lab11/persimmon/README.md

# persimmon
platform to test connectivity of cellular networks around the world
