lab11/persimmon/hardware/sim_card_tester/schematic_pcb.png

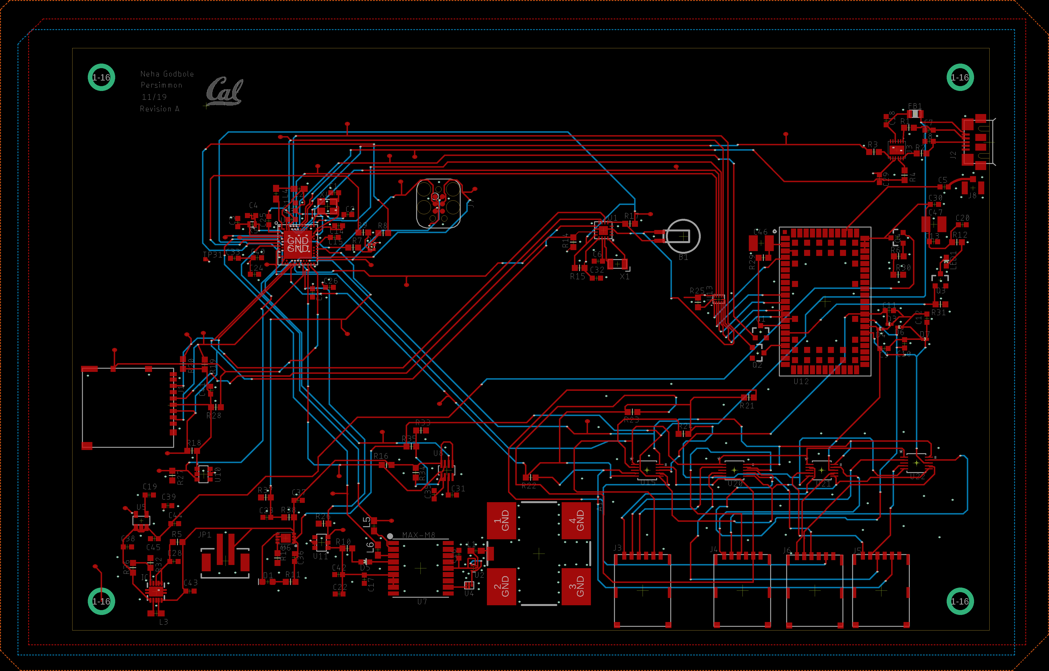
hardware/sim_card_tester/schematic_pcb.png
