lab11/persimmon/hardware/sim_card_tester/schematic.pdf

https://www.u-blox.com/sites/default/files/MAX-8-M8-FW3_HardwareIntegrationManual_%28UBX-15030059%29.pdf

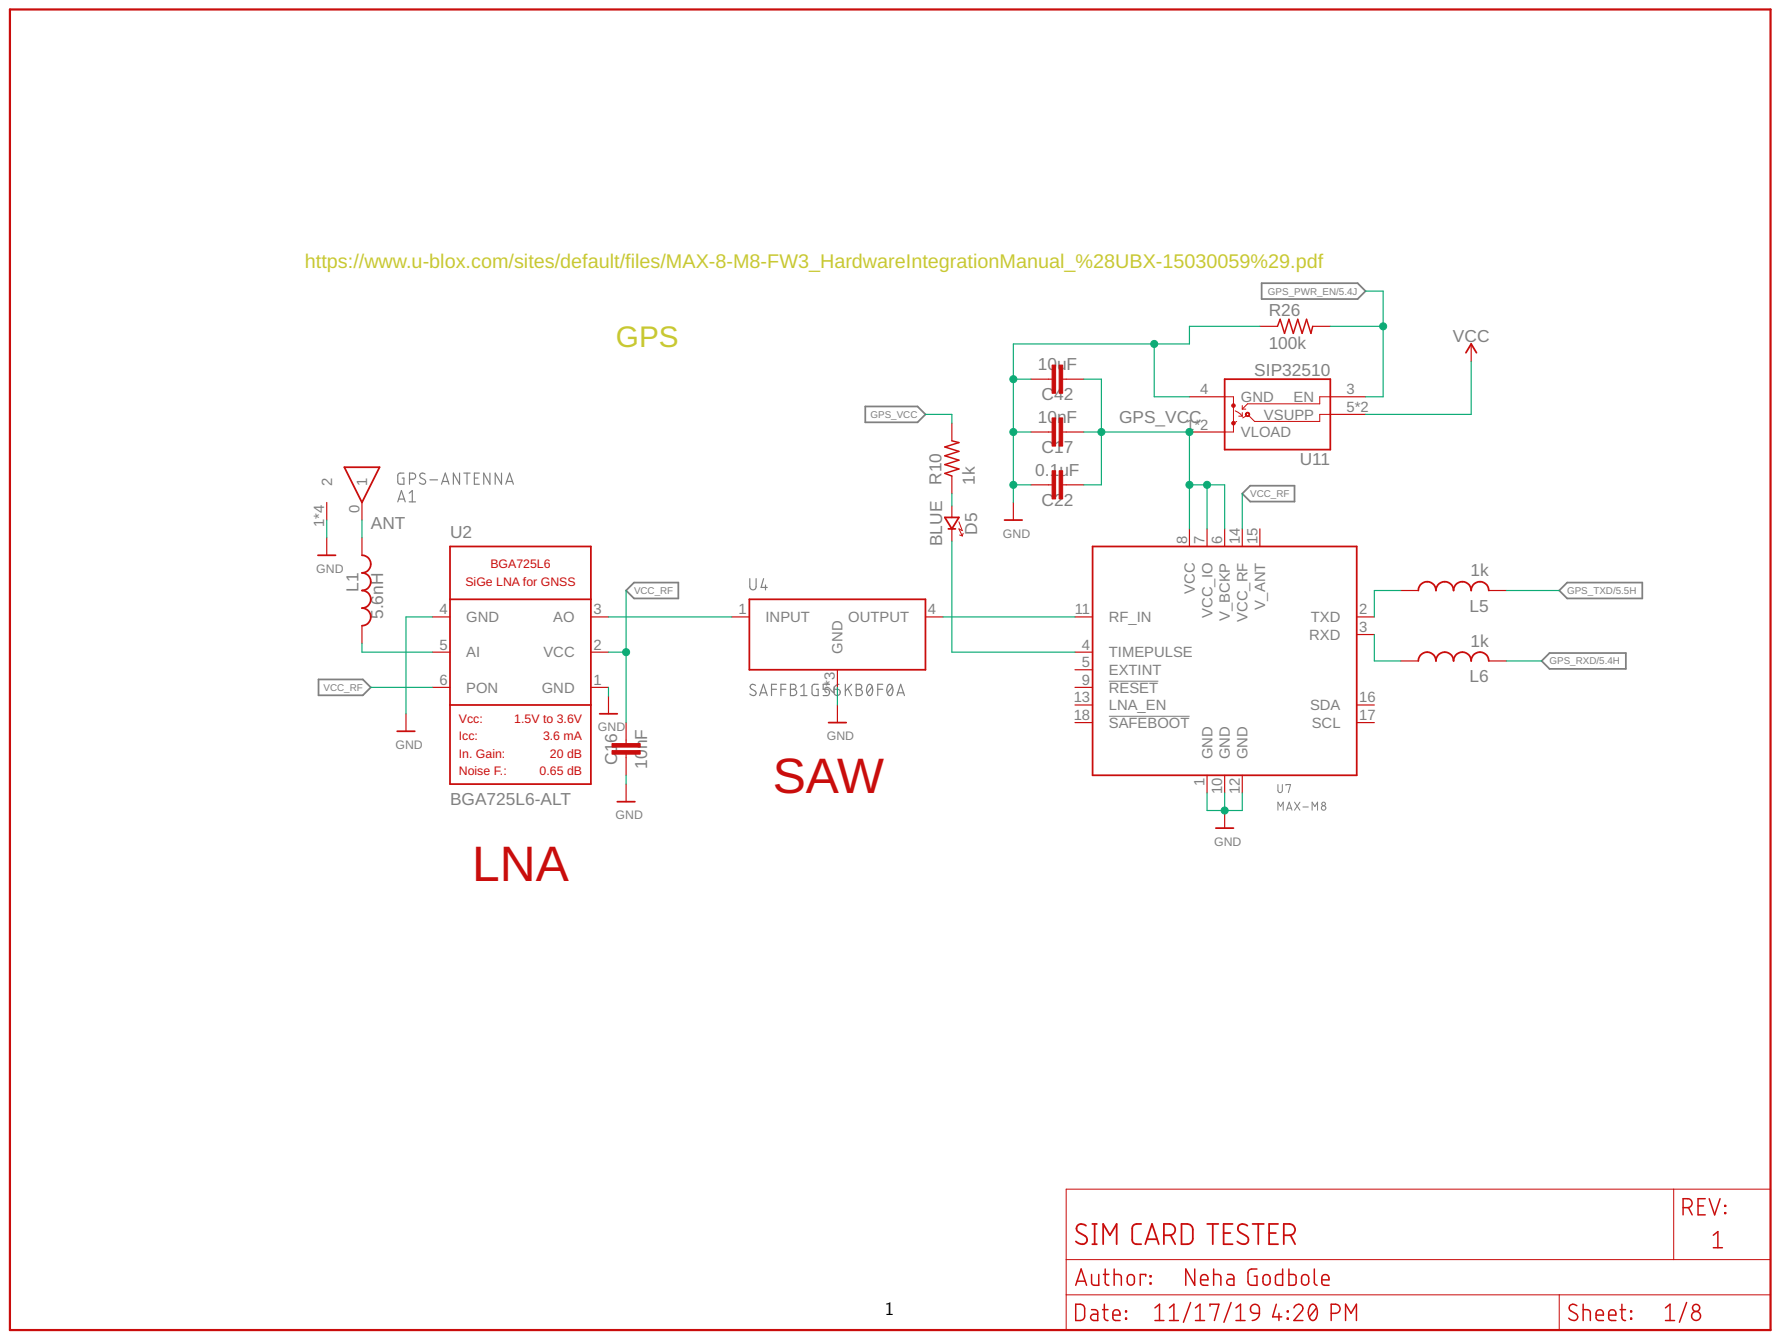
[picture p2: page 1]

Battery plugs in here | PFET to gate the system. Add jumper incase reverse diode voltage
| drop doesn't work as expected with the charging circuit

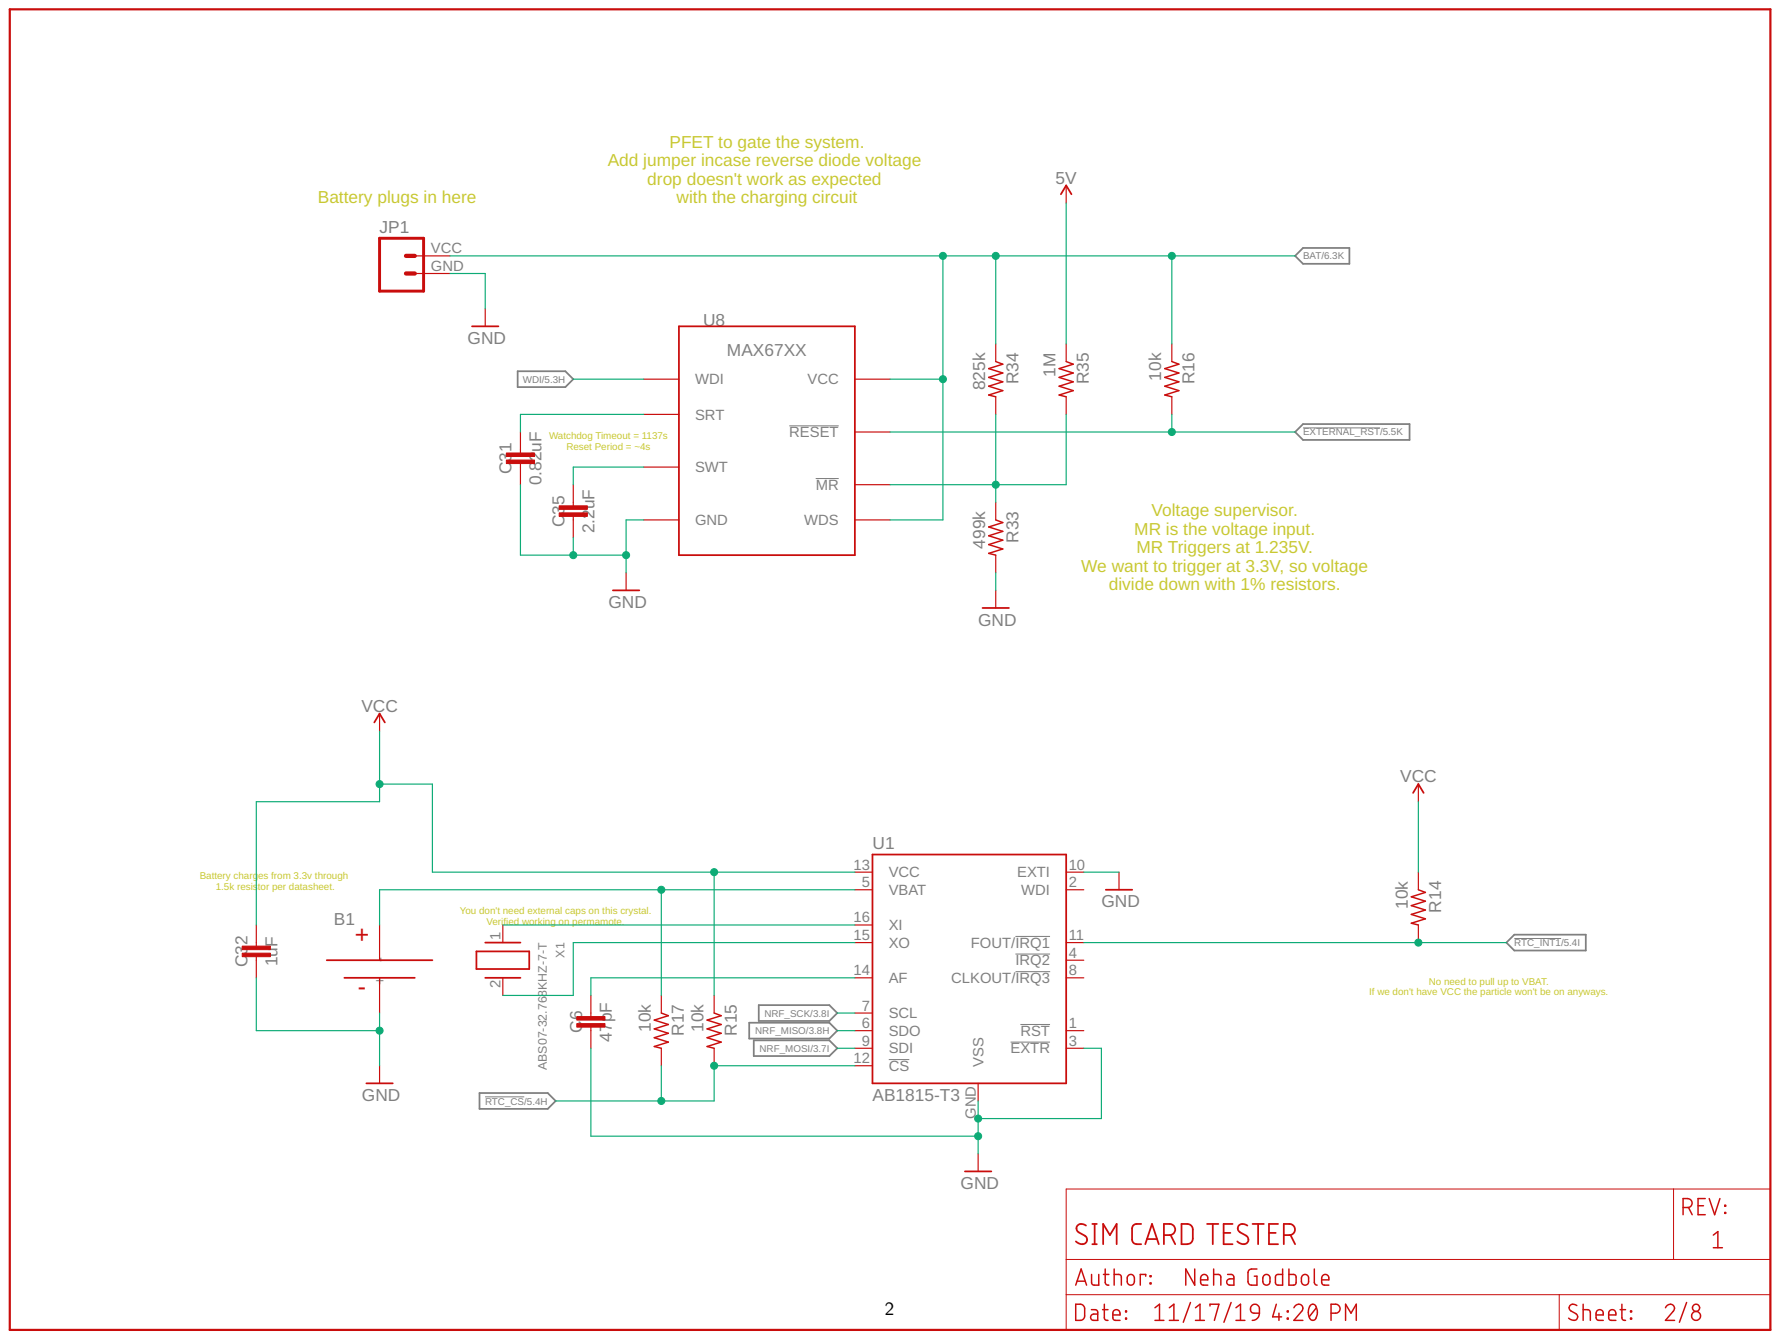
[picture p3: page 2]

Watchdog Timeout = 1137s Reset Period = ~4s

Voltage supervisor. MR is the voltage input. MR Triggers at 1.235V. We want to trigger at 3.3V, so voltage

divide down with 1% resistors.

You don't need external caps on this crystal. Verified working on permamote. Battery charges from 3.3v through
1.5k resistor per datasheet.

If we don't have VCC the particle won't be on anyways.

No need to pull up to VBAT.

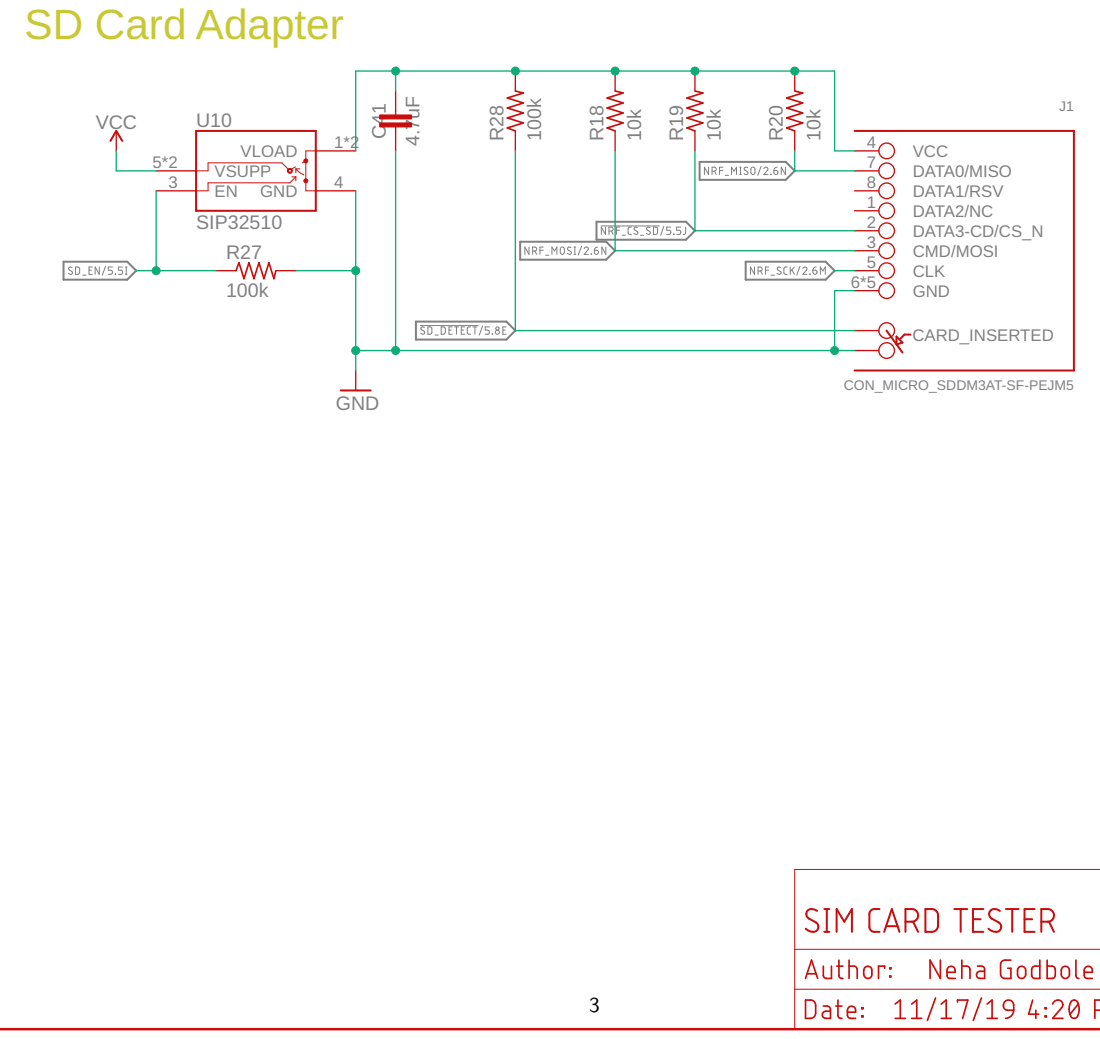
[picture p4: page 3]
3 SD Card Adapter; CARD_INSERTED ⁴.7uF GND; CON_MICRO_SDDM3AT-SF-PEJM5 SIP32510 100k; 10kVCC; C⁴¹; DATA0/MISO 7; DATA1/RSV 8; DATA2/NC 1; DATA3-CD/CS_N 2; CMD/MOSI 3; CLK 5; VCC 4; GND 6*5; J1 VSUPP 5*2; VLOAD; 1*2 GND; R²⁸; R¹⁸; R¹⁹; R²⁰

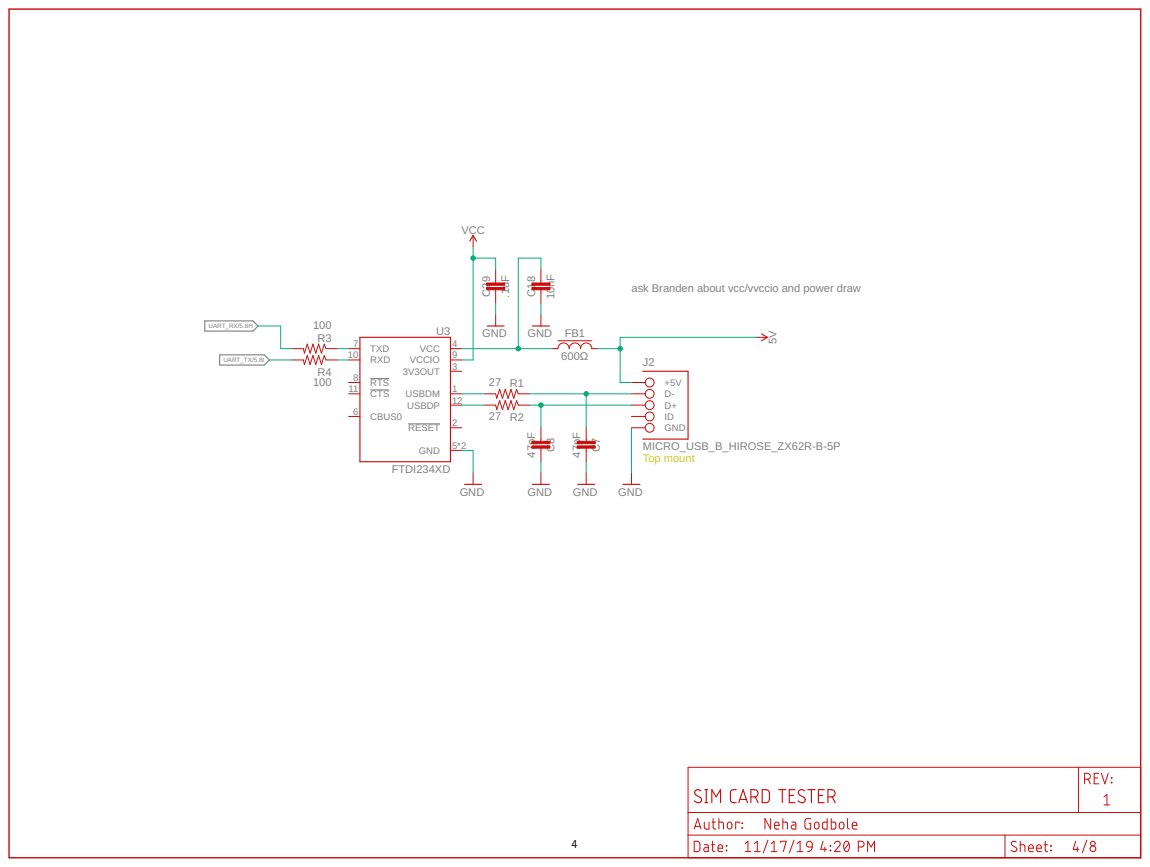
[picture p5: page 4]

ask Branden about vcc/vvccio and power draw

# GND

15nH | 10uH

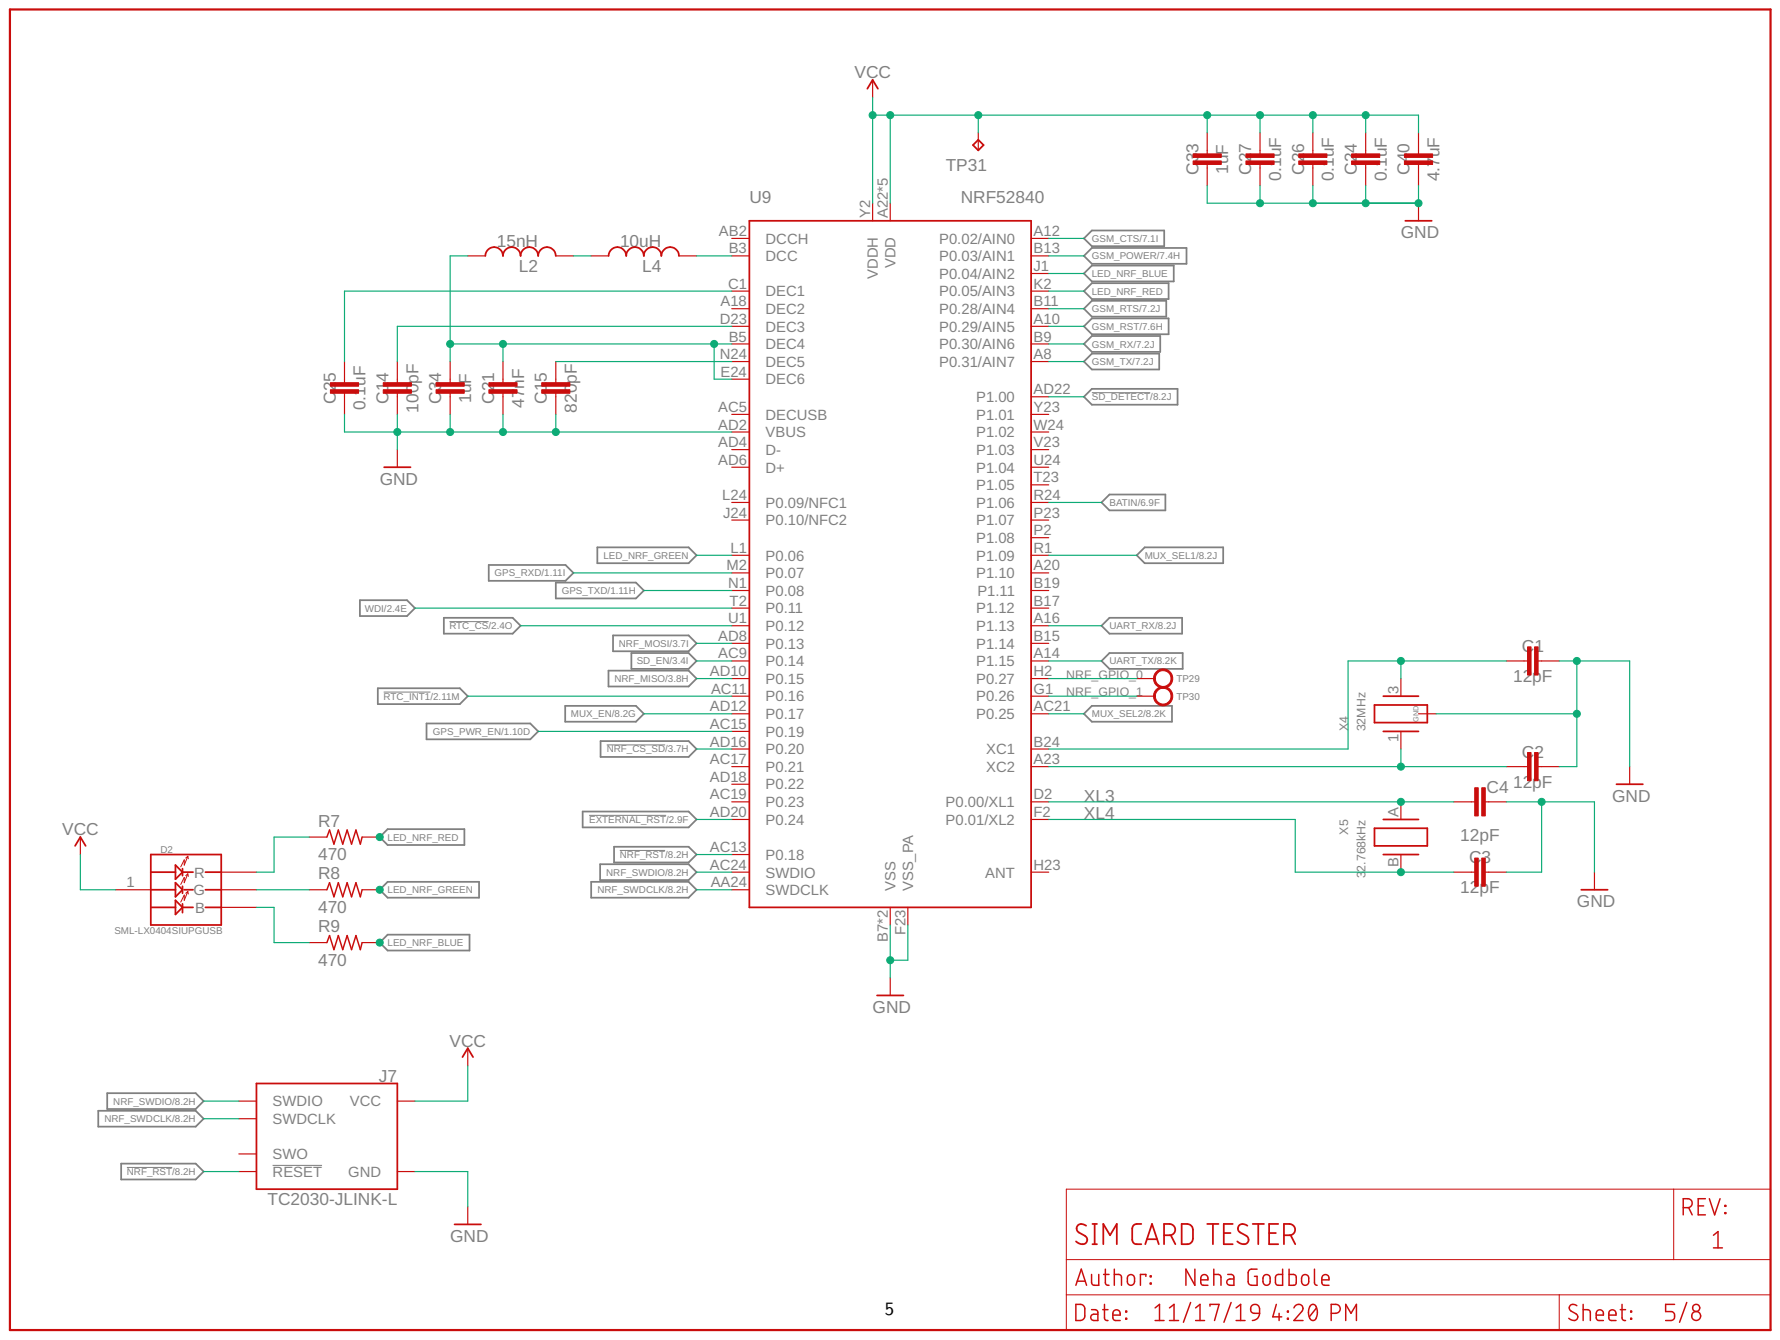
[picture p6: page 5]

# Power Supply and Charging

STAT | VSS GND U6

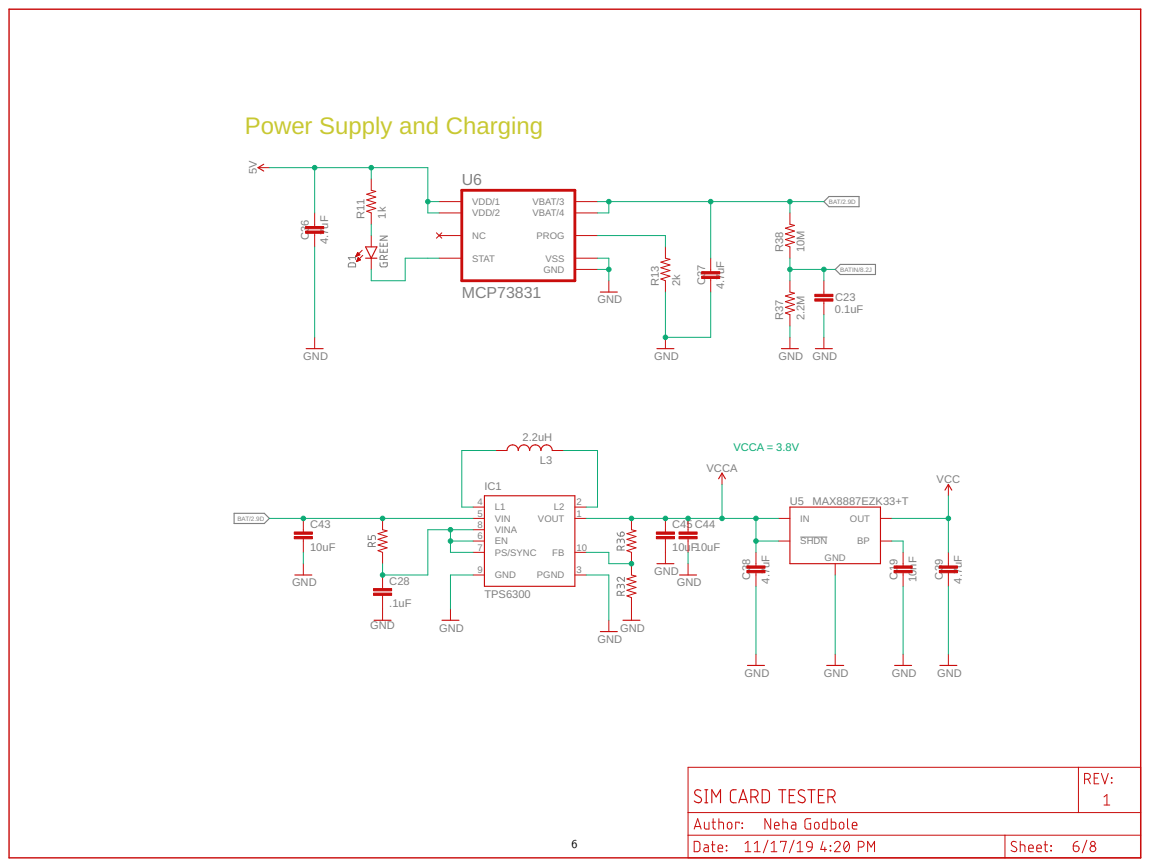
[picture p7: page 6]

# Level Translator, GSM_INT = 1.8V

# VCCA

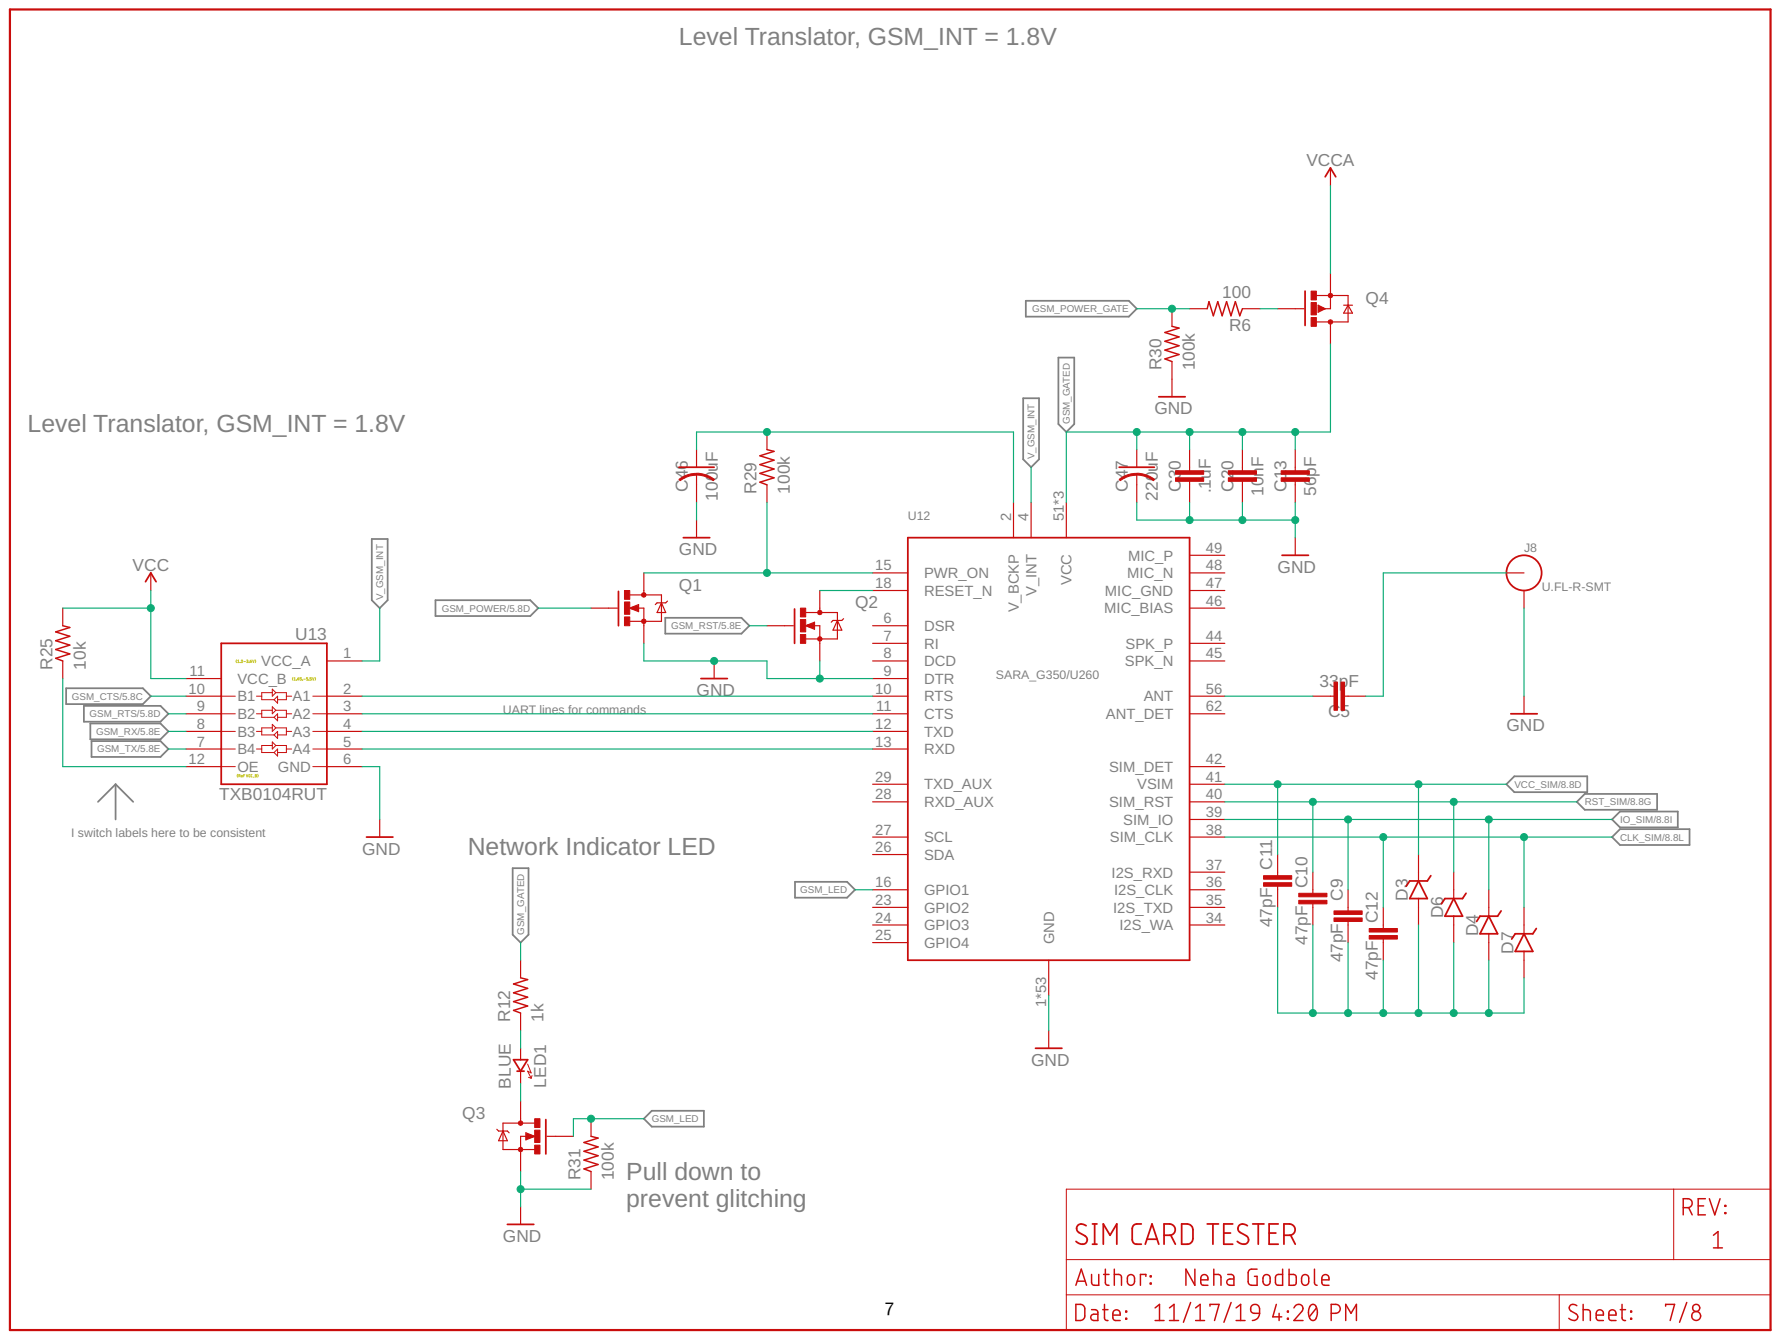
[picture p8: page 7]

UART lines for commands Network Indicator LED

I switch labels here to be consistent

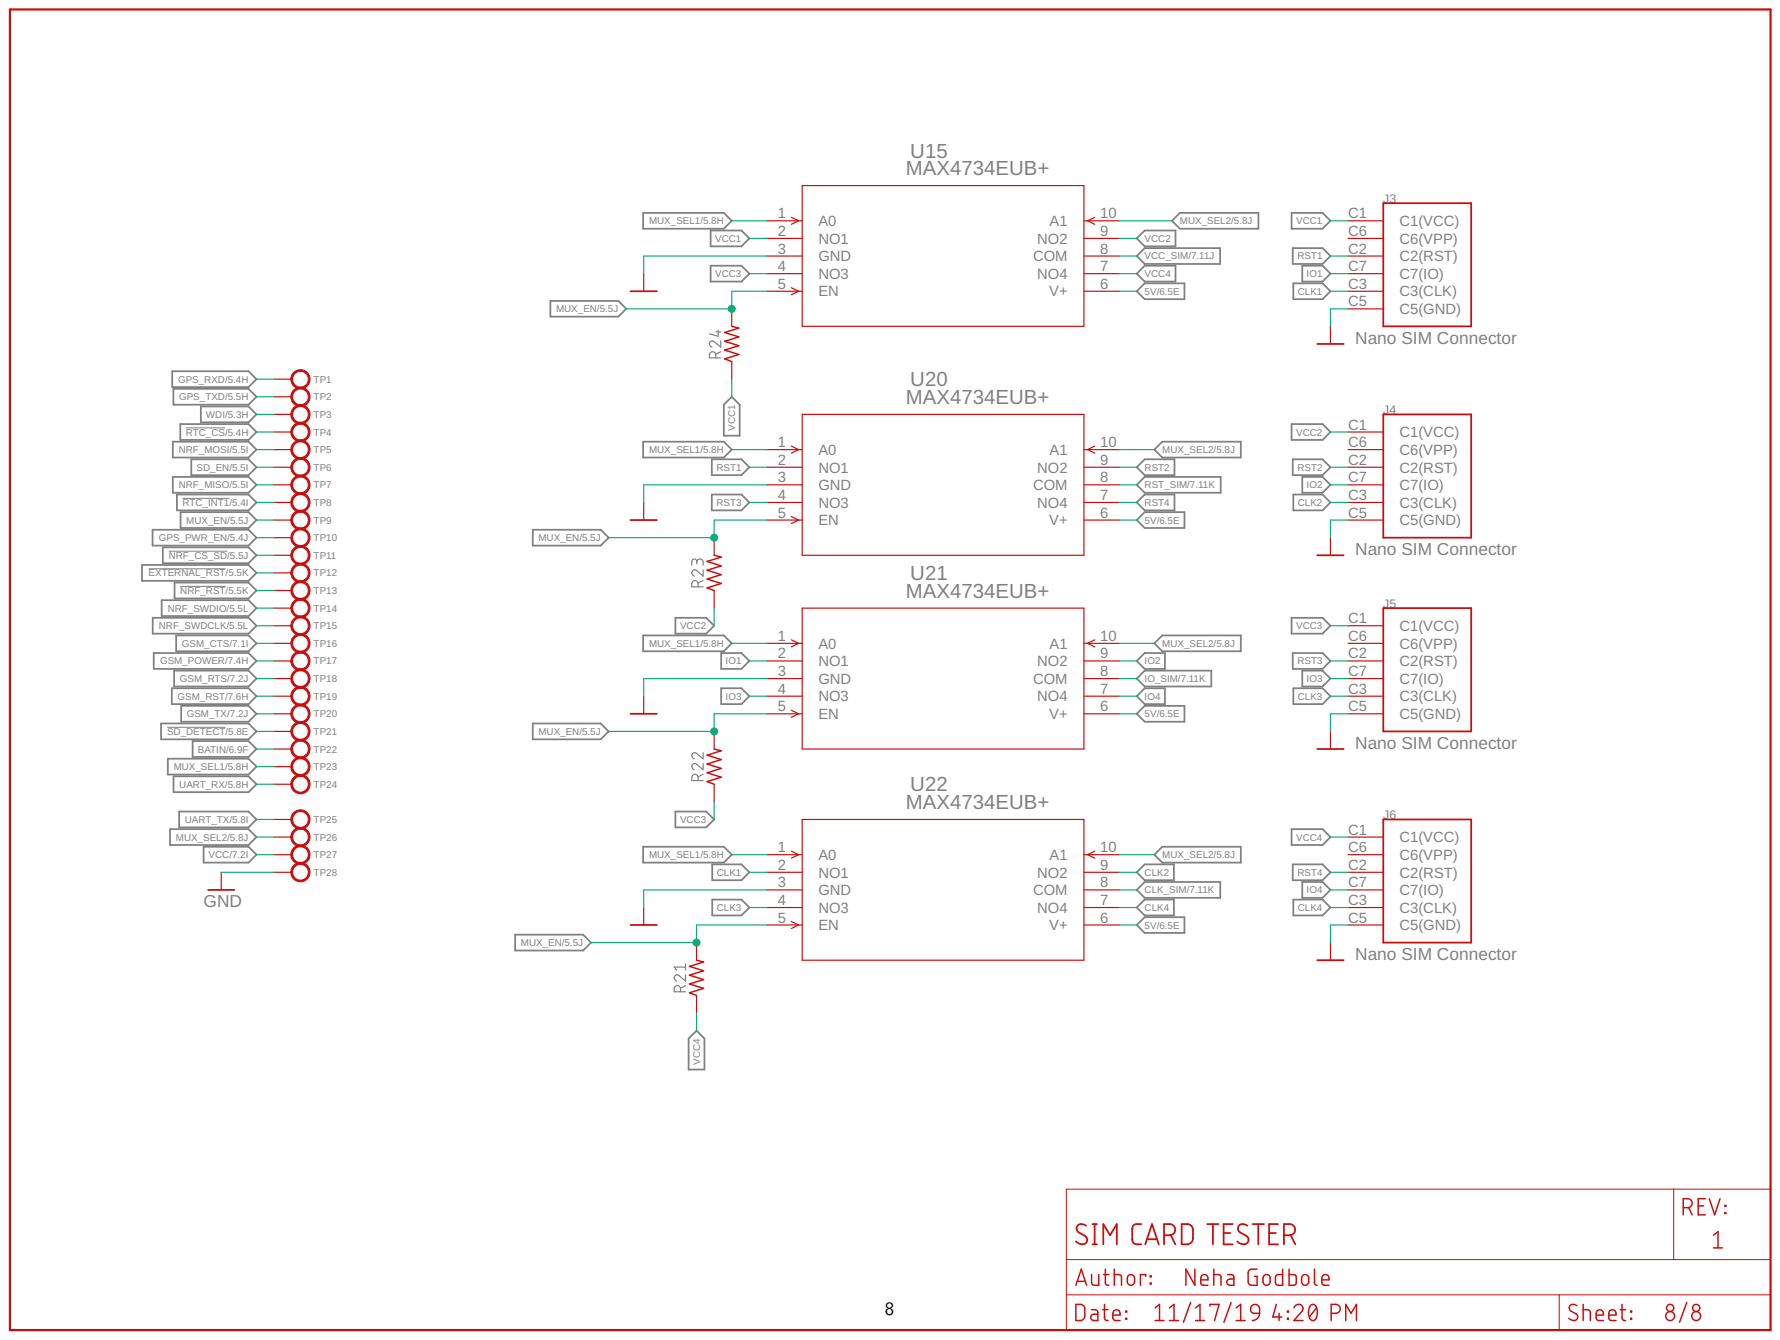
[picture p9: page 8]

Top and Bottom Layers 9 | * | * | * | * L5 L6

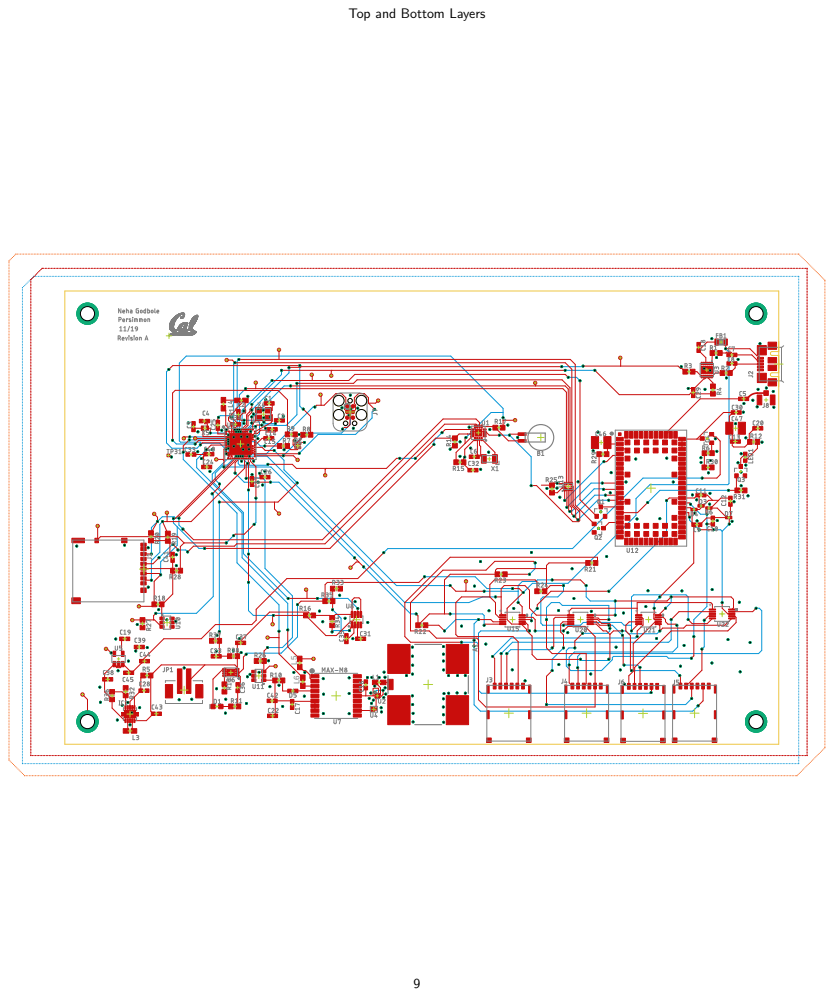
[picture p10: page 9]

# Top Layer

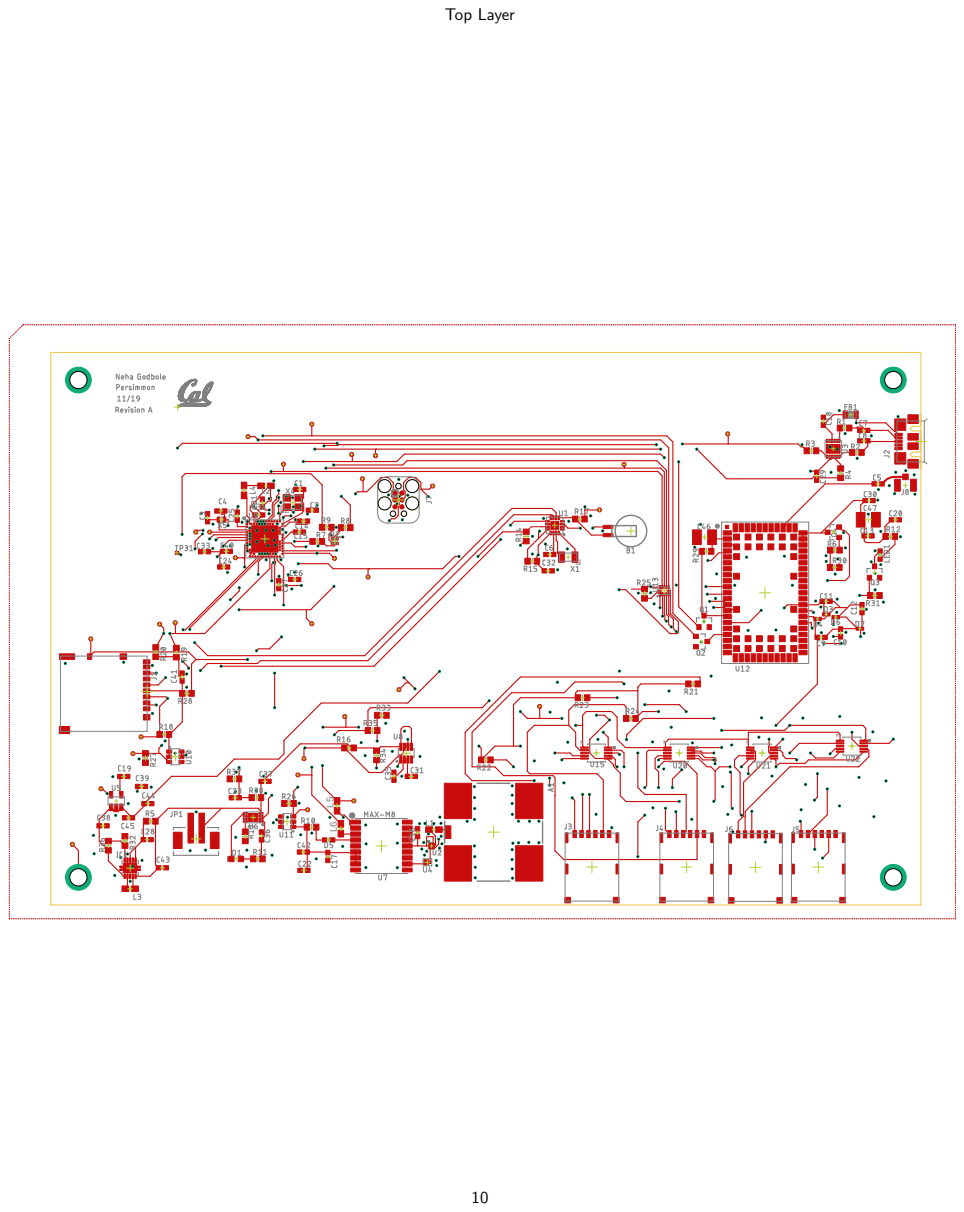
[picture p11: page 10]

# Bottom Layer

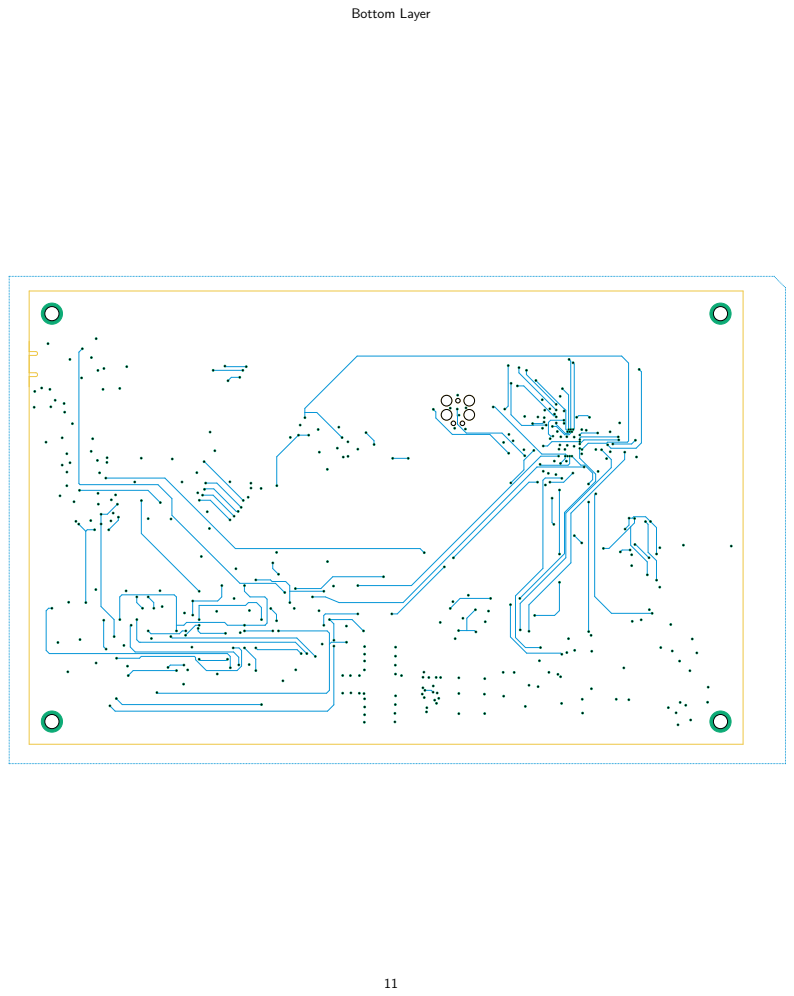
[picture p12: page 11]

# Top Copper Layer

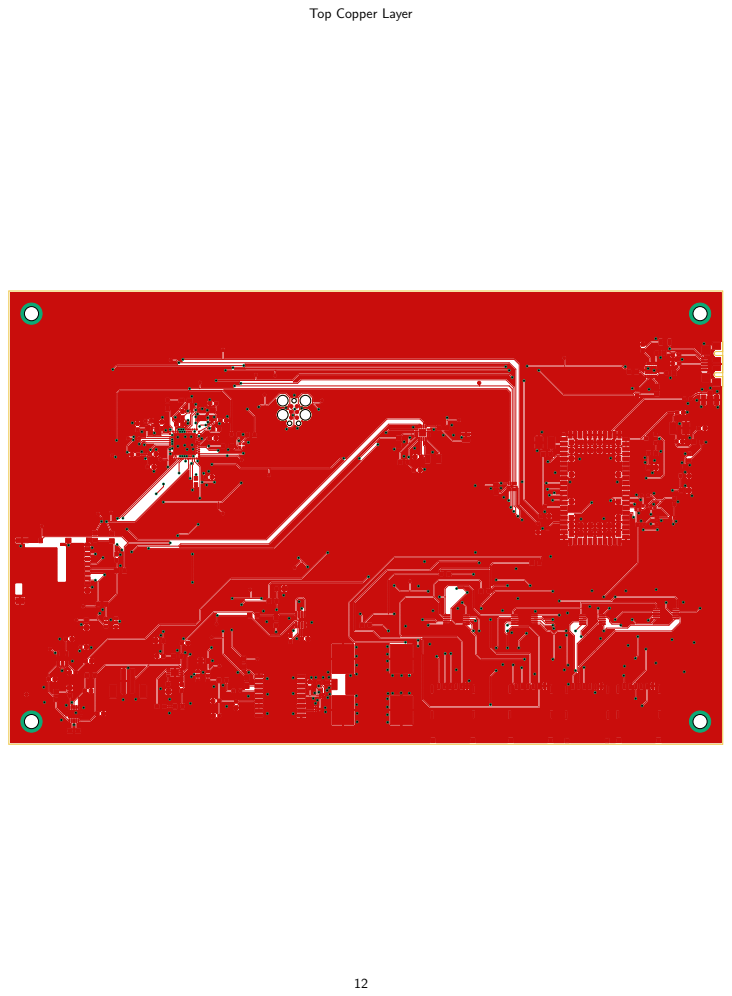
[picture p13: page 12]

# Layer 2 Copper

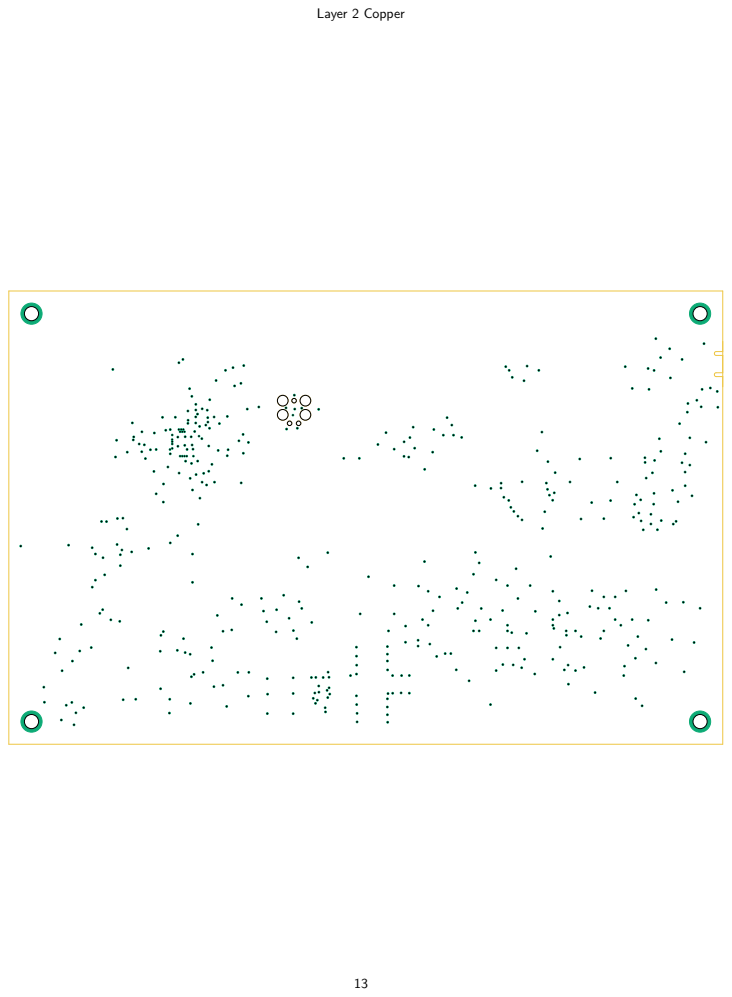
[picture p14: page 13]

# Layer 3 Copper

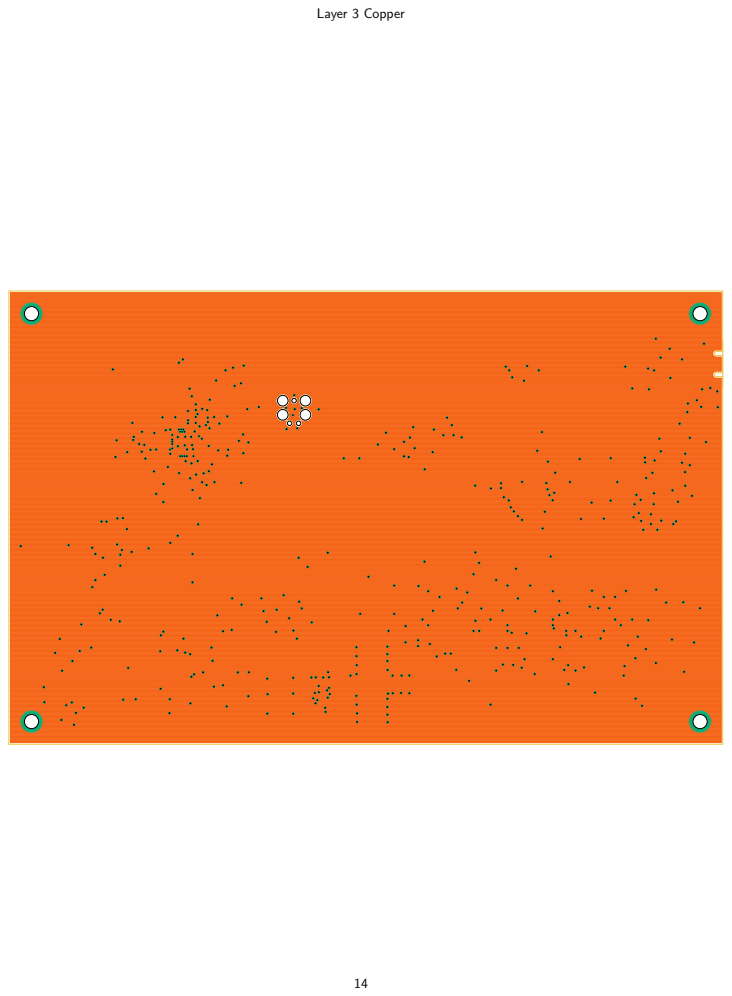
[picture p15: page 14]

# Bottom Copper Layer

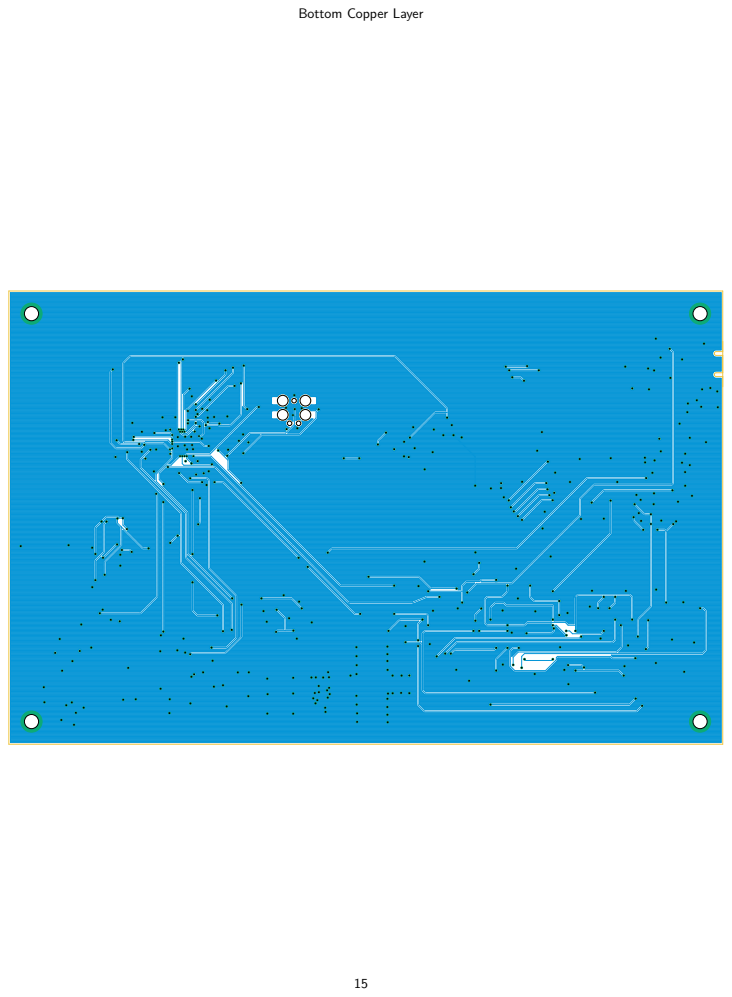
[picture p16: page 15]

# Top Paste Layer with Silkscreen

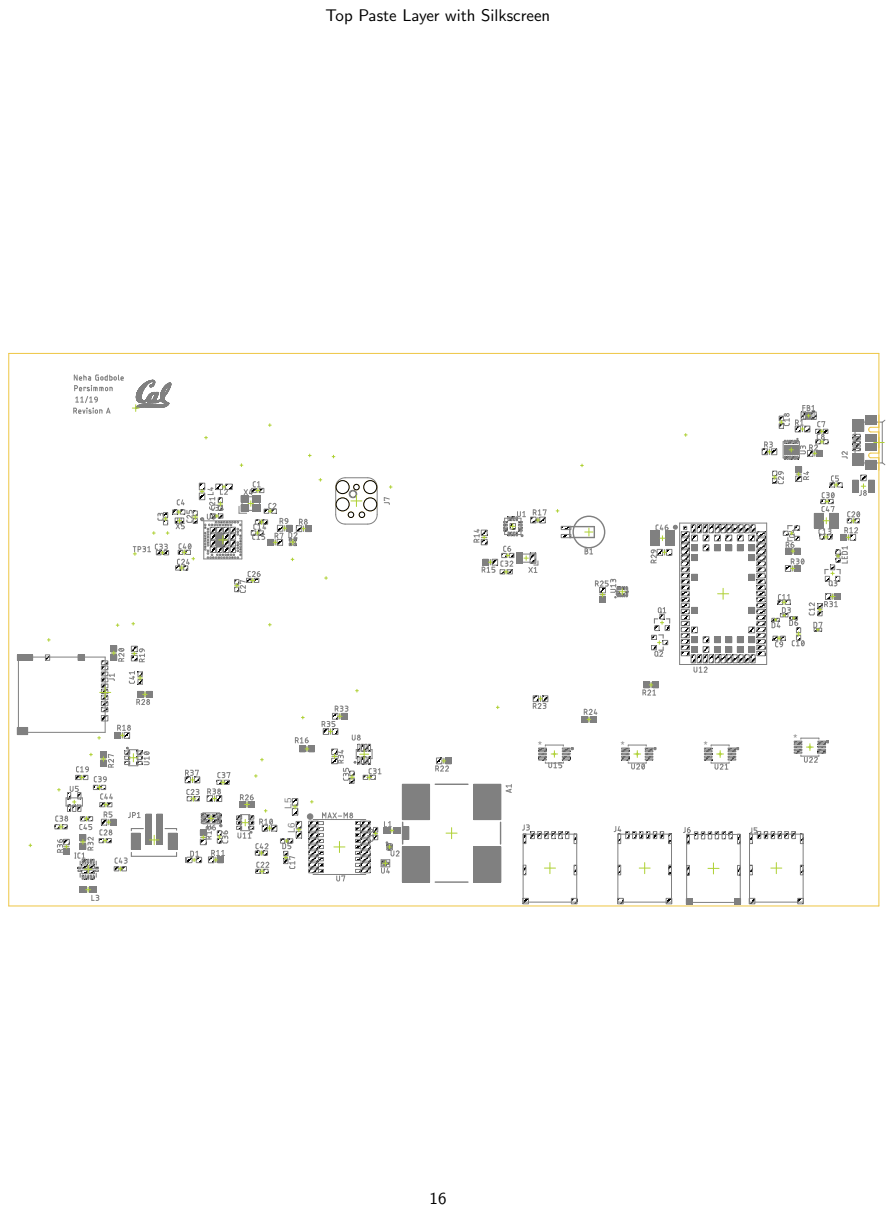
[picture p17: page 16]

# Bottom Paste Layer with Silkscreen

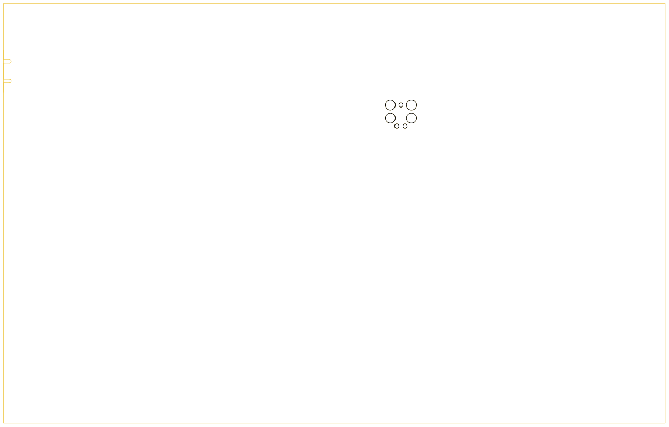
[picture p18: figure]

# Top and Bottom Layers 1:1 Scale

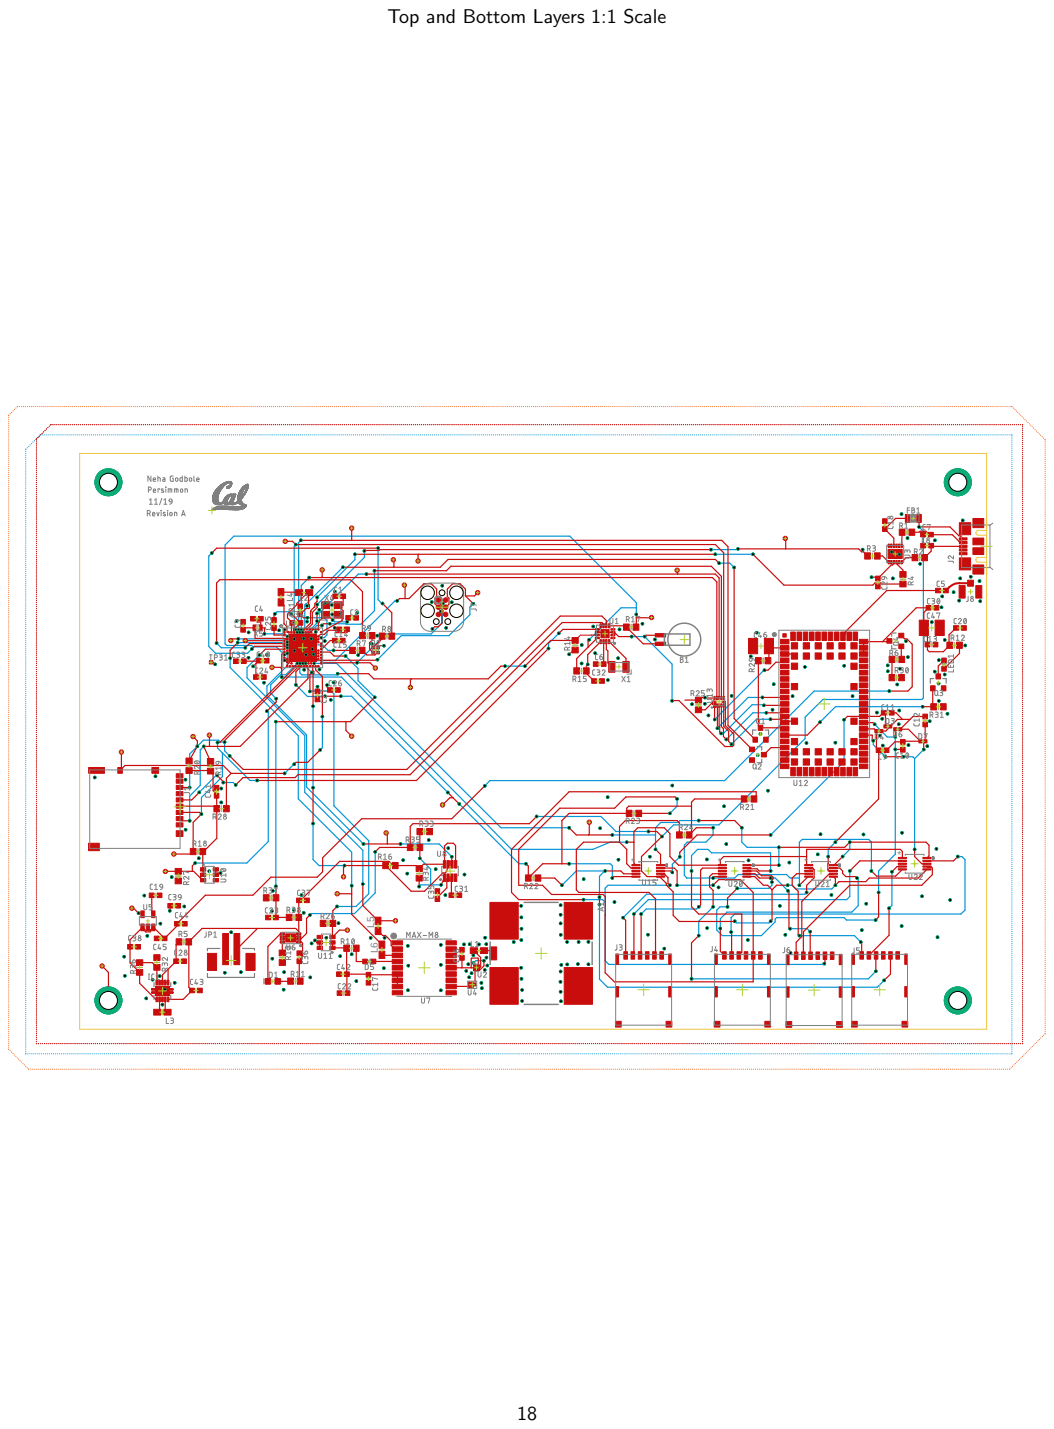
[picture p19: page 18]

# Top Layer 1:1 Scale

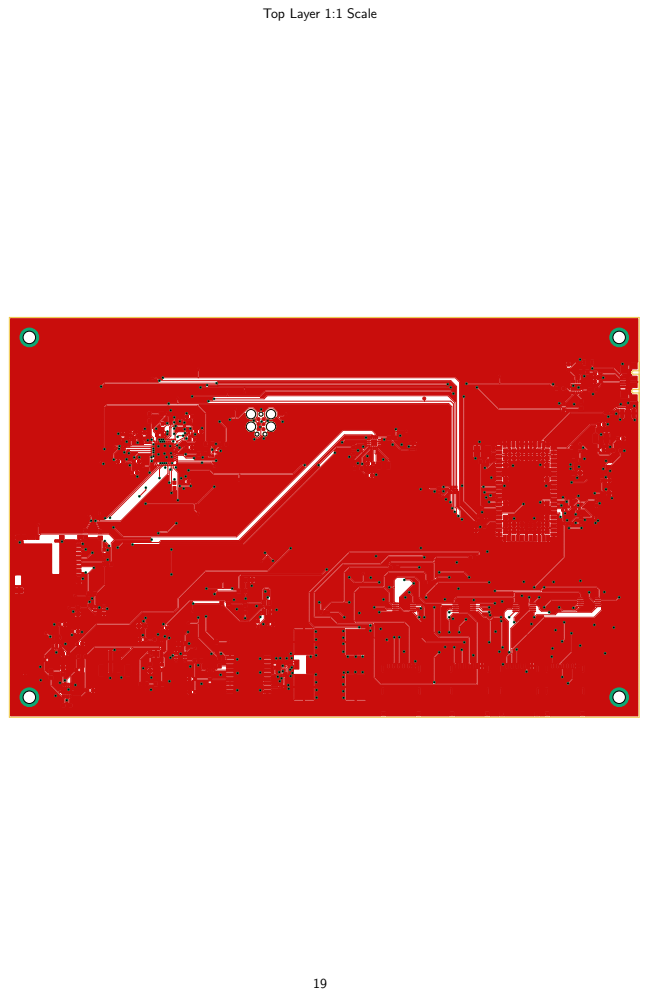
[picture p20: page 19]

# Layer 2 Copper 1:1 Scale

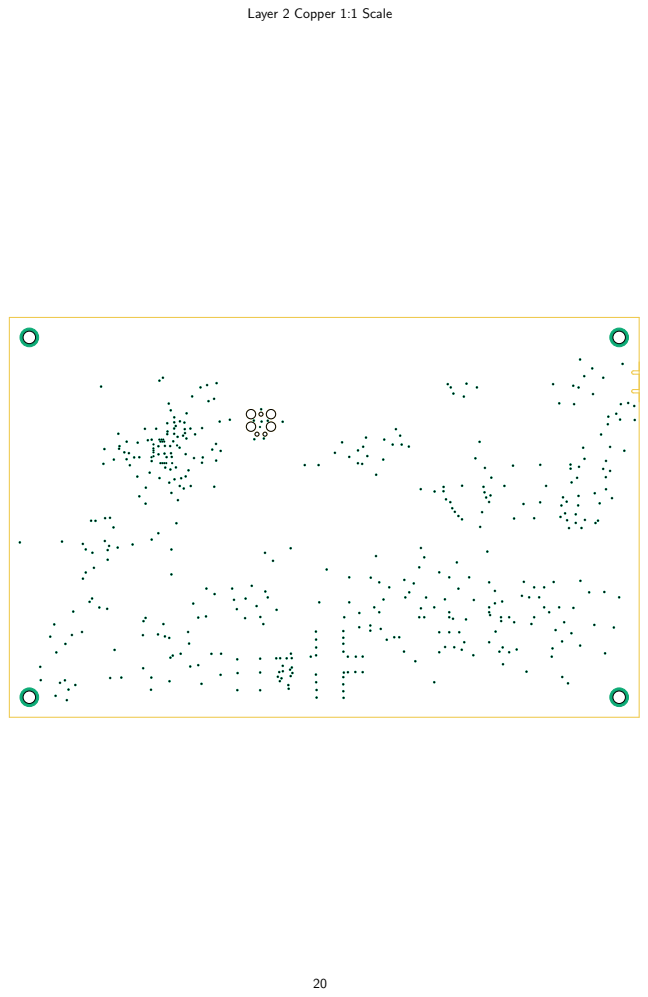
[picture p21: page 20]

# Layer 3 Copper 1:1 Scale

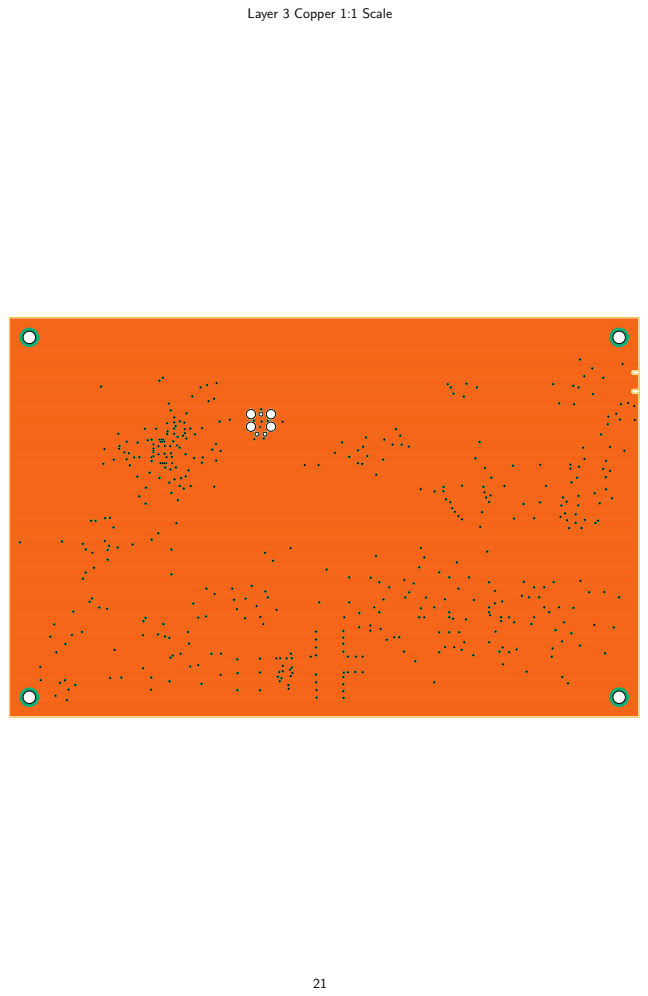
[picture p22: page 21]

# Bottom Copper Layer 1:1 Scale

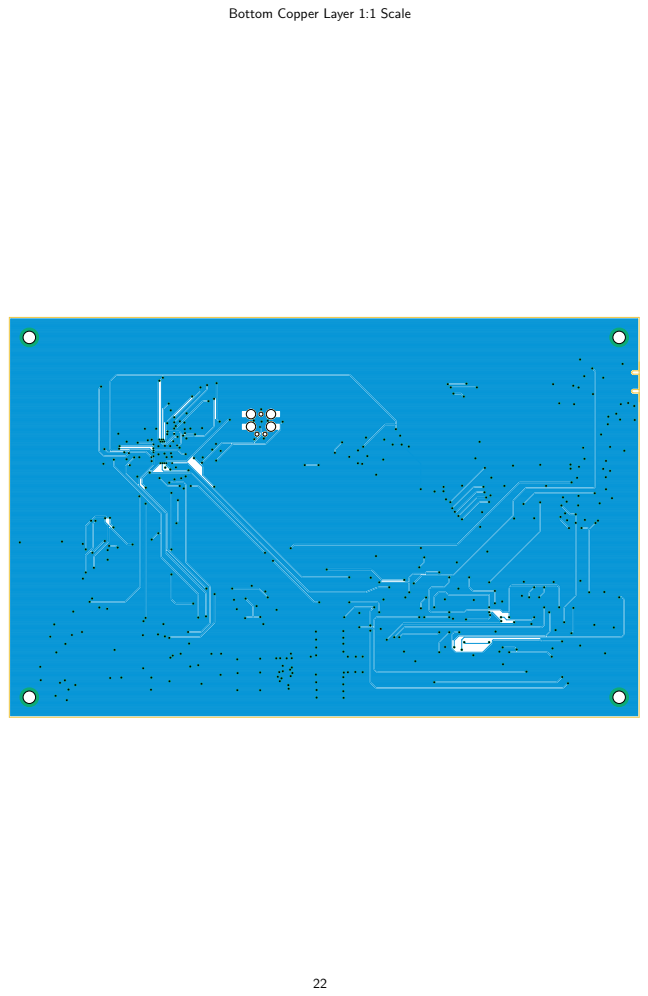
[picture p23: page 22]
