lab11/persimmon/hardware/sim_card_tester/schematic.brd

## EAGLE design hardware/sim_card_tester/schematic.brd (2019-11-18)

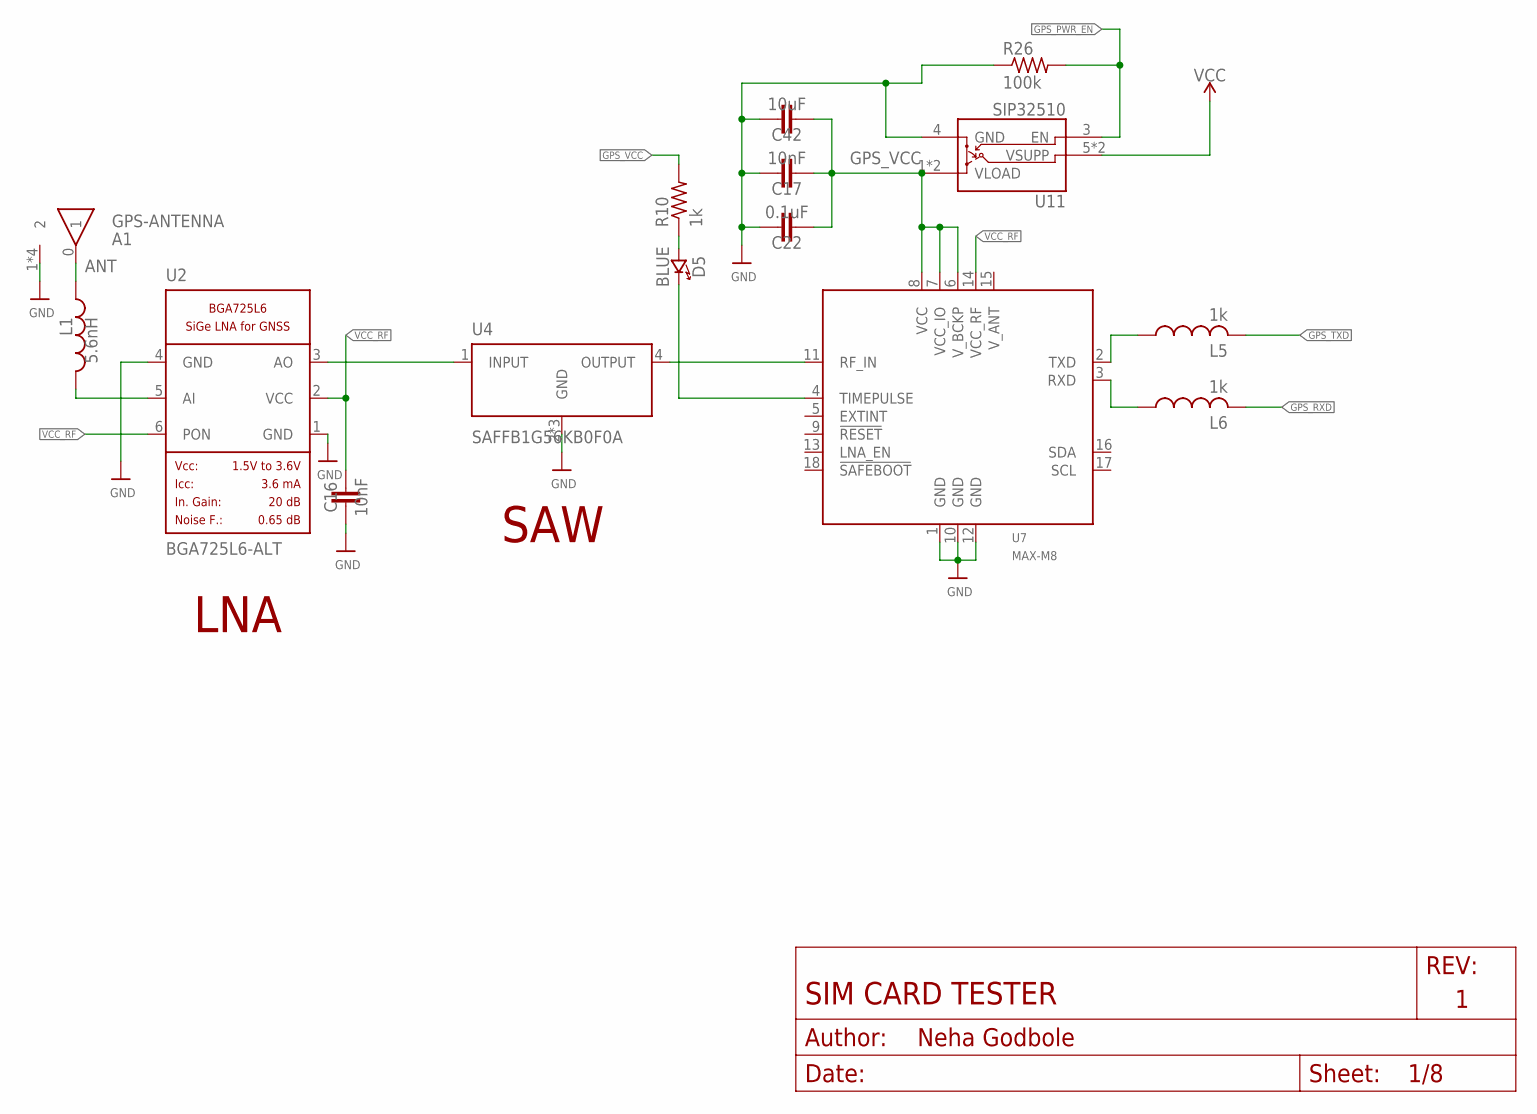
[picture p24: schematic schematic.sch, sheet 1, GPS]

Parts:
A1: GPS-ANTENNA; ANT1818B00BT1516S; MPN ANT1818B00BT1516S; DIGIKEY 311-1531-ND
C16, C17: 10nF; RESC0603_L; MPN GRM033R61E103KA12D; DIGIKEY 490-7194-1-ND
C22: 0.1uF; RESC0603_L; MPN GRM033R61A104ME15D; DIGIKEY 490-5405-1-ND
C42: 10uF; RESC0603_L; MPN GRM188R60J106KE47D; DIGIKEY 490-12538-1-ND
D5: BLUE; LED-0603; MPN LTST-C194TBKT; DIGIKEY 160-1837-6-ND
L1: 5.6nH; RESC0603_M; MPN LQW18AN5N6G8ZD; DIGIKEY 490-15723-1-ND
L5, L6: 1k; RESC0603_M; MPN Murata Electronics; DIGIKEY 490-1015-1-ND
R10: 1k; R0603; MPN RC0603JR-071KL; DIGIKEY 311-1.0KGRCT-ND
R26: 100k; R0603; MPN RC0603JR-07100KL; DIGIKEY 311-100KGRCT-ND
U2: BGA725L6-ALT; LNA-TSLP-6-2-ALT; MPN BGA725L6E6327FTSA1; DIGIKEY BGA725L6E6327FTSA1CT-ND
U4: SAFFB1G56KB0F0A; QCS5I; MPN F6QA1G582H2JM-J; DIGIKEY 587-3990-1-ND
U7: MAX-M8; MPN MAX-M8Q-0; DIGIKEY 672-1003-1-ND
U11: SIP32510; TSOT23-6

Connections:
ANT: A1.0 (1), L1.2
GND: A1.1 (2), A1.2, A1.3 (2), A1.4 (2), C16.1, C17.1, C22.1, C42.1, R26.1, U2.1 (GND), U2.4 (GND), U4.2 (GND), U4.3 (GND), U4.5 (GND), U7.1 (GND), U7.10 (GND), U7.12 (GND), U11.4 (GND); also elsewhere on the board
GPS_PWR_EN: R26.2, U11.3 (EN); also elsewhere on the board
GPS_RF_IN: U4.4 (OUTPUT), U7.11 (RF_IN)
GPS_RXD: L6.2; also elsewhere on the board
GPS_TXD: L5.2; also elsewhere on the board
GPS_VCC: C17.2, C22.2, C42.2, R10.2, U7.6 (V_BCKP), U7.7 (VCC_IO), U7.8 (VCC), U11.1 (VLOAD), U11.2 (VLOAD)
LNA_IN: L1.1, U2.5 (AI)
LNA_OUT: U2.3 (AO), U4.1 (INPUT)
unnamed: D5.A (ANODE), R10.1
unnamed: D5.C (CATHODE), U7.4 (TIMEPULSE)
unnamed: L5.1, U7.2 (TXD)
unnamed: L6.1, U7.3 (RXD)
VCC: U11.5 (VSUPP), U11.6 (VSUPP); also elsewhere on the board
VCC_RF: C16.2, U2.2 (VCC), U2.6 (PON), U7.14 (VCC_RF)

Notes on the sheet:
LNA
SAW

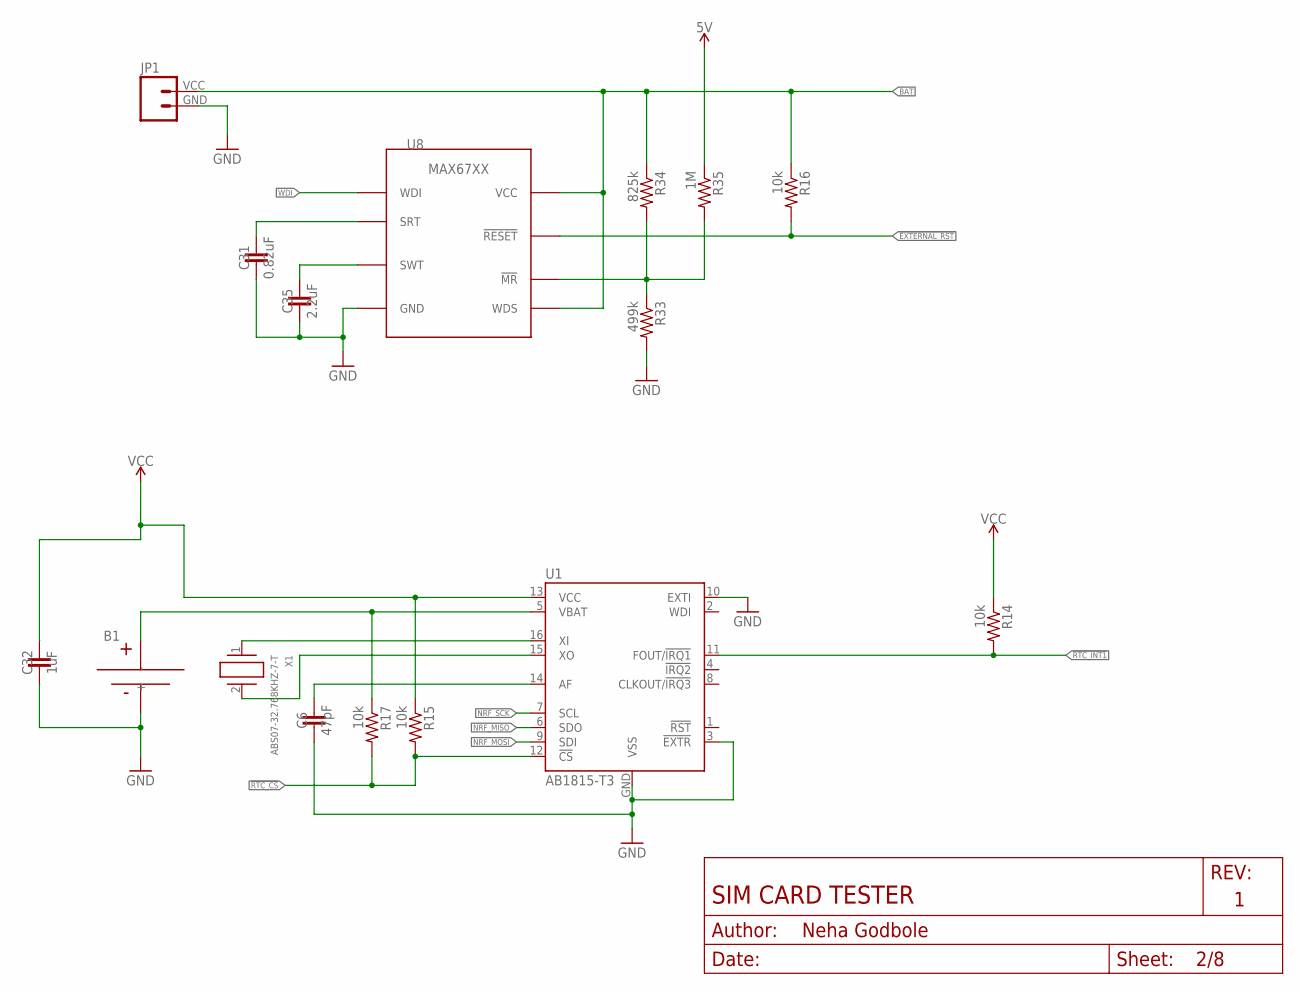
[picture p25: schematic schematic.sch, sheet 2, Hardware Watchdog & RTC]

Parts:
B1: MS518SE; MS518SE-FL35E
C6: 47pF; RESC0603_L; MPN C0603C105K8PACTU; DIGIKEY 399-3118-1-ND
C31: 0.82uF; RESC0603_L; MPN C0603C824K8PACTU; DIGIKEY 399-3117-1-ND
C32: 1uF; RESC0603_L; MPN C0603C105K8PACTU; DIGIKEY 399-3118-1-ND
C35: 2.2uF; RESC0603_L; MPN GRM188R61E225MA12D; DIGIKEY 490-12738-1-ND
JP1: M024UCON-15767; JST-2-SMD-VERT; MPN B2B-PH-SM4-TB(LF)(SN); DIGIKEY 455-1734-1-ND
R14, R15, R16, R17: 10k; R0603; MPN RC0603JR-0710KL; DIGIKEY 311-10KGRCT-ND
R33: 499k; R0603; MPN RC0603FR-07499KL; DIGIKEY 311-499KHRCT-ND
R34: 825k; R0603; MPN RC0603FR-07825KL; DIGIKEY 311-825KHRCT-ND
R35: 1M; R0603; MPN RC0603FR-071ML; DIGIKEY 311-1.00MHRCT-ND
U1: AB1815-T3; QFN-16-3MM
U8: MAX67XXMAX6749MAX67XX; SOT-23-8
X1: ABS07-32.768KHZ-7-T; 2-SMD

Connections:
5V: R35.1; also elsewhere on the board
!EXTERNAL_RST: R16.2, U8.7 (!RESET); also elsewhere on the board
!RTC_CS: R15.2, R17.2, U1.12 (!CS); also elsewhere on the board
!RTC_INT1: R14.2, U1.11 (FOUT/!IRQ1); also elsewhere on the board
BAT: JP1.VCC (2), R16.1, R34.1, U8.5 (WDS), U8.8 (VCC); also elsewhere on the board
GND: B1.-, C6.2, C31.2, C32.2, C35.2, JP1.GND (1), R33.2, U1.3 (!EXTR), U1.10 (EXTI), U1.GND (VSS), U8.4 (GND); also elsewhere on the board
unnamed: B1.+, R17.1, U1.5 (VBAT)
unnamed: C6.1, U1.14 (AF)
unnamed: U1.15 (XO), X1.2
unnamed: U1.16 (XI), X1.1
unnamed: R33.1, R34.2, R35.2, U8.1 (!MR)
unnamed: C31.1, U8.3 (SRT)
unnamed: C35.1, U8.2 (SWT)
NRF_MISO: U1.6 (SDO); also elsewhere on the board
NRF_MOSI: U1.9 (SDI); also elsewhere on the board
NRF_SCK: U1.7 (SCL); also elsewhere on the board
VCC: C32.1, R14.1, R15.1, U1.13 (VCC); also elsewhere on the board
WDI: U8.6 (WDI); also elsewhere on the board

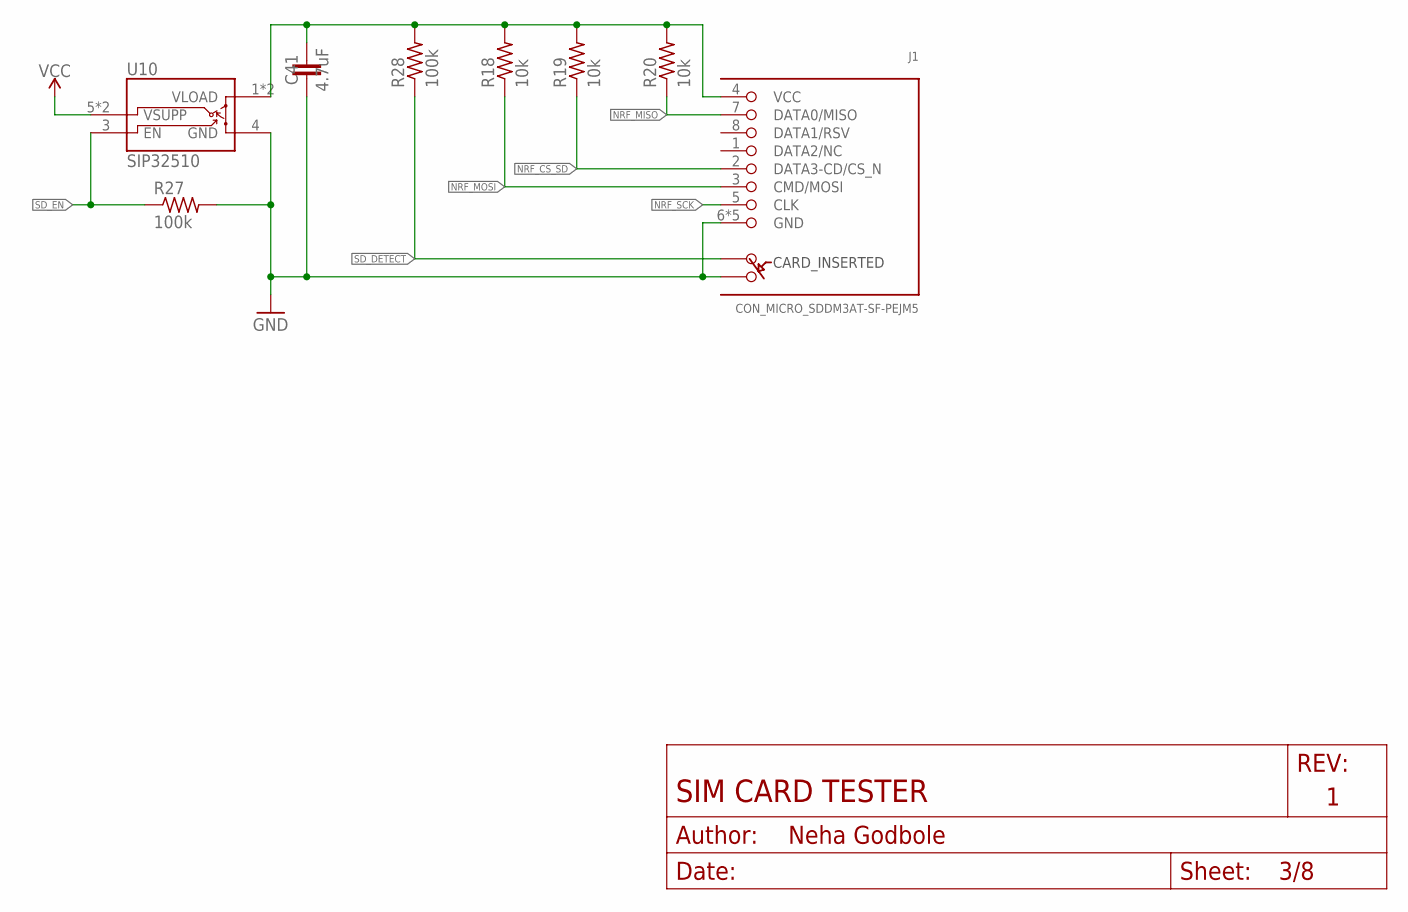
[picture p26: schematic schematic.sch, sheet 3, SD Card Adapter]

Parts:
C41: 4.7uF; RESC0603_L; MPN ZRB18AR6YA475KE05L; DIGIKEY 490-10992-1-ND
J1: CON_MICRO_SDDM3AT-SF-PEJM5; DM3AT-SF-PEJM5; MPN DM3AT-SF-PEJM5
R18, R19, R20: 10k; R0603; MPN RC0603JR-0710KL; DIGIKEY 311-10KGRCT-ND
R27, R28: 100k; R0603; MPN RC0603JR-07100KL; DIGIKEY 311-100KGRCT-ND
U10: SIP32510; TSOT23-6

Connections:
!NRF_CS_SD: J1.2 (DATA3-CD/CS_N), R19.1; also elsewhere on the board
!SD_DETECT: J1.A, R28.1; also elsewhere on the board
GND: C41.2, J1.6 (GND), J1.B, J1.MOUNT0 (GND), J1.MOUNT1 (GND), J1.MOUNT2 (GND), J1.MOUNT3 (GND), R27.2, U10.4 (GND); also elsewhere on the board
unnamed: C41.1, J1.4 (VCC), R18.2, R19.2, R20.2, R28.2, U10.1 (VLOAD), U10.2 (VLOAD)
NRF_MISO: J1.7 (DATA0/MISO), R20.1; also elsewhere on the board
NRF_MOSI: J1.3 (CMD/MOSI), R18.1; also elsewhere on the board
NRF_SCK: J1.5 (CLK); also elsewhere on the board
SD_EN: R27.1, U10.3 (EN); also elsewhere on the board
VCC: U10.5 (VSUPP), U10.6 (VSUPP); also elsewhere on the board

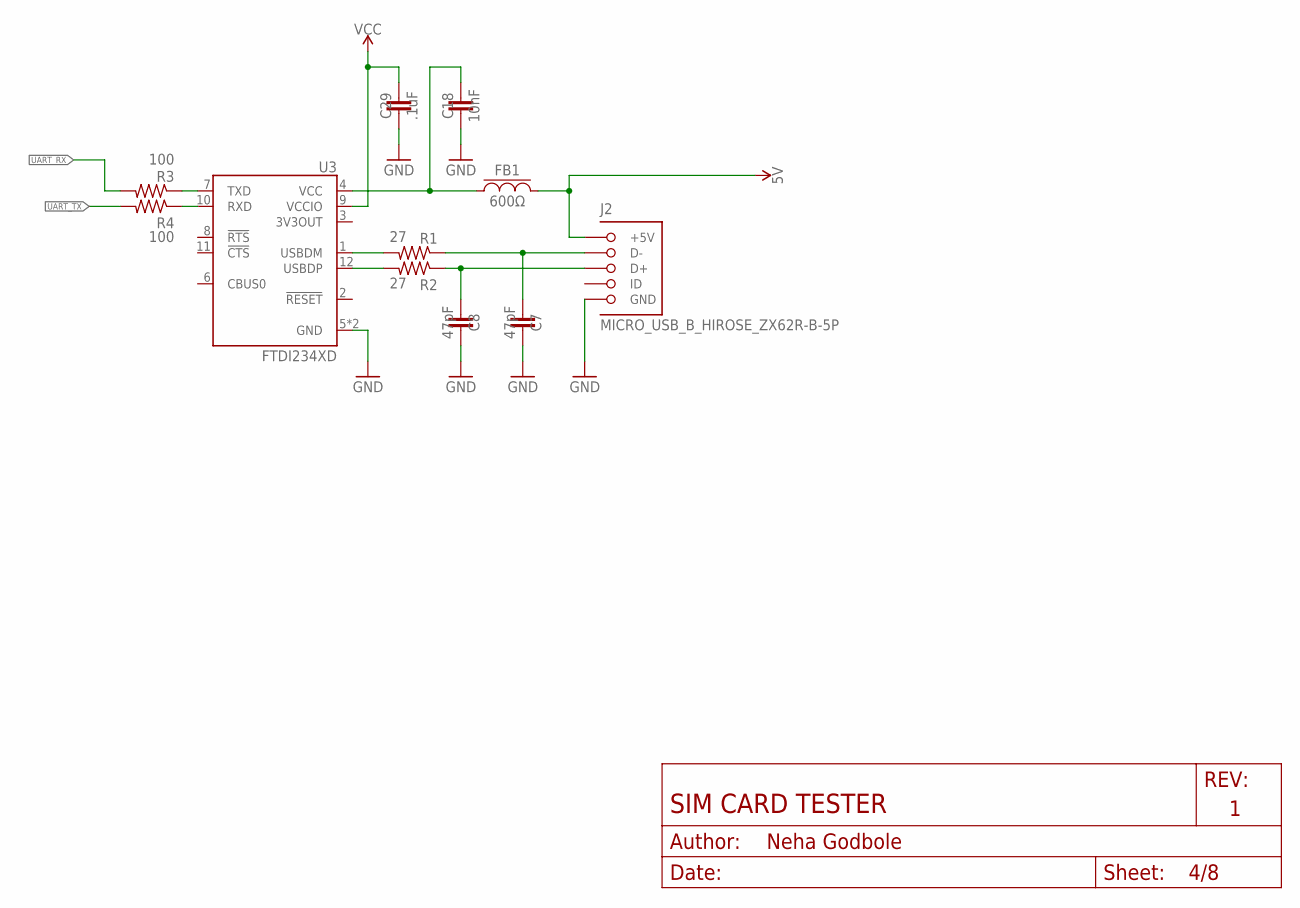
[picture p27: schematic schematic.sch, sheet 4, USB]

Parts:
C7, C8: 47pF; RESC0603_L; MPN CC0603JRNPO9BN470; DIGIKEY 311-1065-1-ND
C18: 10nF; RESC0603_L; MPN GRM033R61E103KA12D; DIGIKEY 490-7194-1-ND
C29: .1uF; RESC0603_L; MPN GRM033R61A104ME15D; DIGIKEY 490-5405-1-ND
FB1: 600Ω; 0805_CAP; DIGIKEY 240-2390-1-ND
J2: MICRO_USB_B_HIROSE_ZX62R-B-5P; USB_MICRO_B-HIROSE-ZX62R-B-5P; DIGIKEY H125274CT-ND
R1, R2: 27; R0603; MPN RC0603JR-0727RL; DIGIKEY 311-27GRCT-ND
R3, R4: 100; R0603; MPN RC0603FR-07100RL; DIGIKEY 311-100HRCT-ND
U3: FTDI234XD; DFN-12/3MM

Connections:
5V: FB1.P$2, J2.1 (+5V); also elsewhere on the board
D+: C8.1, J2.3 (D+), R2.1
D-: C7.1, J2.2 (D-), R1.1
GND: C7.2, C8.2, C18.2, C29.2, J2.5 (GND), U3.5 (GND), U3.13 (GND); also elsewhere on the board
unnamed: R1.2, U3.1 (USBDM)
unnamed: R2.2, U3.12 (USBDP)
unnamed: R4.1, U3.10 (RXD)
unnamed: R3.1, U3.7 (TXD)
unnamed: C18.1, FB1.P$1, U3.4 (VCC)
UART_RX: R3.2; also elsewhere on the board
UART_TX: R4.2; also elsewhere on the board
VCC: C29.1, U3.9 (VCCIO); also elsewhere on the board

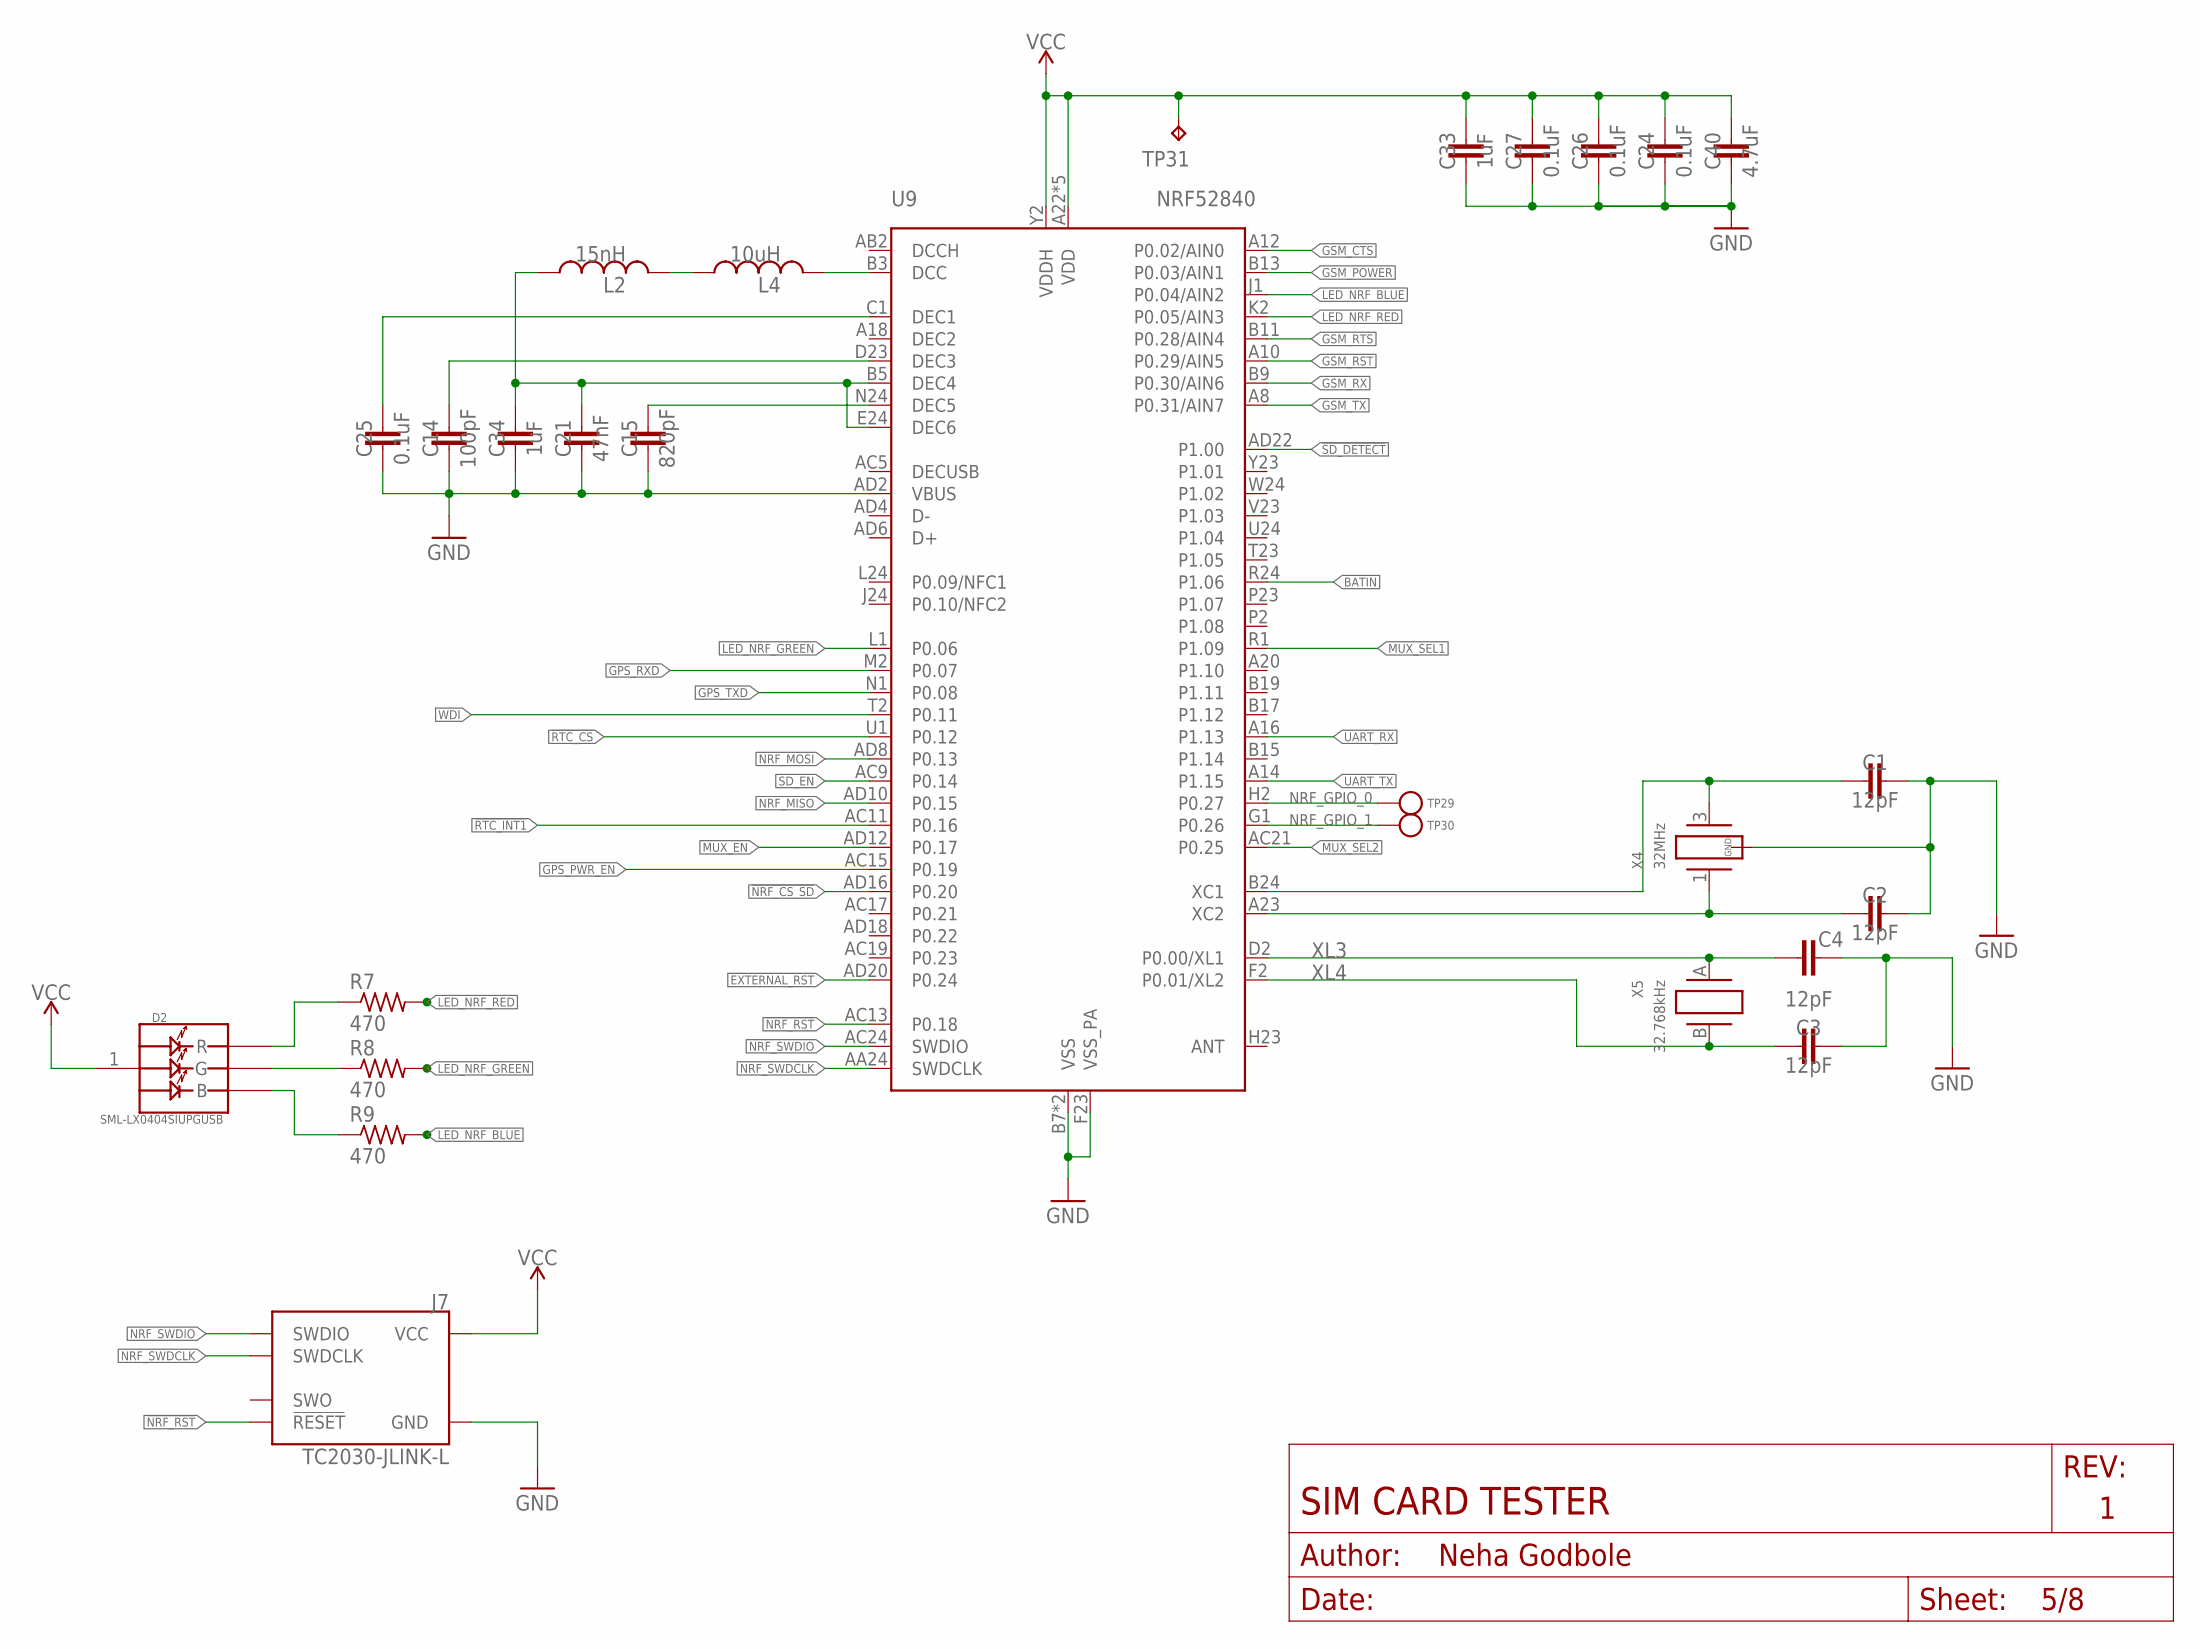
[picture p28: schematic schematic.sch, sheet 5, NRF]

Parts:
C1, C2, C3, C4: 12pF; RESC0603_L; MPN CC0603JRNPO9BN120; DIGIKEY 311-1059-1-ND
C14: 100pF; RESC0603_L; MPN CC0603JRNPO9BN101; DIGIKEY 311-1069-1-ND
C15: 820pF; RESC0603_L; MPN CC0603KRX7R9BB821; DIGIKEY 311-1189-1-ND
C21: 47nF; RESC0603_L; MPN GCJ188R71H473KA12D; DIGIKEY 490-5854-1-ND
C24, C25, C26, C27: 0.1uF; RESC0603_L; MPN GRM033R61A104ME15D; DIGIKEY 490-5405-1-ND
C33, C34: 1uF; RESC0603_L; MPN C0603C105K8PACTU; DIGIKEY 399-3118-1-ND
C40: 4.7uF; RESC0603_L; MPN ZRB18AR6YA475KE05L; DIGIKEY 490-10992-1-ND
D2: SML-LX0404SIUPGUSB; 1MM_SQ_4PAD
J7: TC2030-JLINK-L; TC2030-IDC
L2: 15nH; RESC0603_M; MPN LQW18AN15NG8ZD; DIGIKEY 490-15648-1-ND
L4: 10uH; RESC0603_M; MPN CBMF1608T100K; DIGIKEY 587-1720-1-ND
R7, R8, R9: 470; R0603; MPN RC0603FR-07470RL; DIGIKEY 311-470HRCT-ND
TP29, TP30: TEST-POINT; PAD.03X.03
TP31: TPTP06SQ; TP06SQ
U9: NRF52840; AQFN73
X4: 32MHz; TXC-7V
X5: 32.768kHz; ABS05

Connections:
!EXTERNAL_RST: U9.AD20 (P0.24); also elsewhere on the board
!NRF_CS_SD: U9.AD16 (P0.20); also elsewhere on the board
!NRF_RST: J7.3 (!RESET), U9.AC13 (P0.18); also elsewhere on the board
!RTC_CS: U9.U1 (P0.12); also elsewhere on the board
!RTC_INT1: U9.AC11 (P0.16); also elsewhere on the board
!SD_DETECT: U9.AD22 (P1.00); also elsewhere on the board
BATIN: U9.R24 (P1.06); also elsewhere on the board
GND: C1.1, C2.1, C3.1, C4.1, C14.2, C15.2, C21.2, C24.2, C25.2, C26.2, C27.2, C33.2, C34.2, C40.2, J7.5 (GND), U9.AD2 (VBUS), U9.B7 (VSS), U9.F23 (VSS_PA), U9.GND (VSS), X4.2 (GND), X4.4 (GND); also elsewhere on the board
GPS_PWR_EN: U9.AC15 (P0.19); also elsewhere on the board
GPS_RXD: U9.M2 (P0.07); also elsewhere on the board
GPS_TXD: U9.N1 (P0.08); also elsewhere on the board
GSM_CTS: U9.A12 (P0.02/AIN0); also elsewhere on the board
GSM_POWER: U9.B13 (P0.03/AIN1); also elsewhere on the board
GSM_RST: U9.A10 (P0.29/AIN5); also elsewhere on the board
GSM_RTS: U9.B11 (P0.28/AIN4); also elsewhere on the board
GSM_RX: U9.B9 (P0.30/AIN6); also elsewhere on the board
GSM_TX: U9.A8 (P0.31/AIN7); also elsewhere on the board
LED_NRF_BLUE: R9.2, U9.J1 (P0.04/AIN2)
LED_NRF_GREEN: R8.2, U9.L1 (P0.06)
LED_NRF_RED: R7.2, U9.K2 (P0.05/AIN3)
MUX_EN: U9.AD12 (P0.17); also elsewhere on the board
MUX_SEL1: U9.R1 (P1.09); also elsewhere on the board
MUX_SEL2: U9.AC21 (P0.25); also elsewhere on the board
unnamed: C25.1, U9.C1 (DEC1)
unnamed: C21.1, C34.1, L2.1, U9.B5 (DEC4), U9.E24 (DEC6)
unnamed: C14.1, U9.D23 (DEC3)
unnamed: C1.2, U9.B24 (XC1), X4.3 (2)
unnamed: C2.2, U9.A23 (XC2), X4.1
unnamed: L4.2, U9.B3 (DCC)
unnamed: L2.2, L4.1
unnamed: C15.1, U9.N24 (DEC5)
unnamed: D2.2 (R), R7.1
unnamed: D2.4 (G), R8.1
unnamed: D2.3 (B), R9.1
NRF_GPIO_0: TP29.P$1, U9.H2 (P0.27)
NRF_GPIO_1: TP30.P$1, U9.G1 (P0.26)
NRF_MISO: U9.AD10 (P0.15); also elsewhere on the board
NRF_MOSI: U9.AD8 (P0.13); also elsewhere on the board
NRF_SWDCLK: J7.4 (SWDCLK), U9.AA24 (SWDCLK); also elsewhere on the board
NRF_SWDIO: J7.2 (SWDIO), U9.AC24 (SWDIO); also elsewhere on the board
SD_EN: U9.AC9 (P0.14); also elsewhere on the board
UART_RX: U9.A16 (P1.13); also elsewhere on the board
UART_TX: U9.A14 (P1.15); also elsewhere on the board
VCC: C24.1, C26.1, C27.1, C33.1, C40.1, D2.1 (VDD), J7.1 (VCC), TP31.TP, U9.A22 (VDD), U9.AD14 (VDD), U9.AD23 (VDD), U9.B1 (VDD), U9.W1 (VDD), U9.Y2 (VDDH); also elsewhere on the board
WDI: U9.T2 (P0.11); also elsewhere on the board
XL3: C4.2, U9.D2 (P0.00/XL1), X5.A (1)
XL4: C3.2, U9.F2 (P0.01/XL2), X5.B (2)

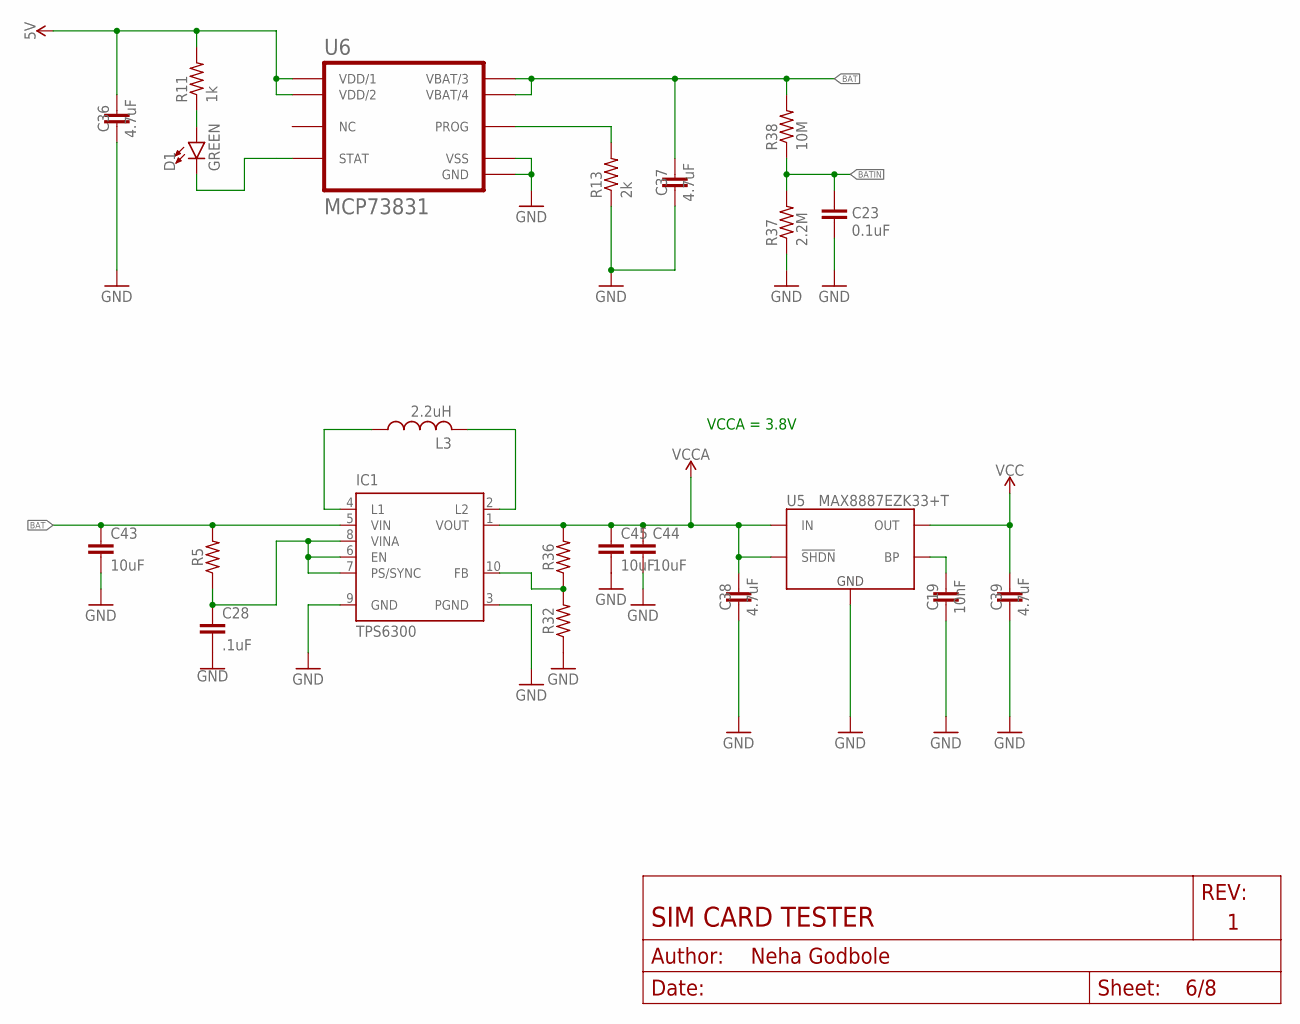
[picture p29: schematic schematic.sch, sheet 6, Power Suppy and Charging]

Parts:
C19: 10nF; RESC0603_L; MPN GRM033R61E103KA12D; DIGIKEY 490-7194-1-ND
C23: 0.1uF; RESC0603_L; MPN GRM033R61A104ME15D; DIGIKEY 490-5405-1-ND
C28: .1uF; RESC0603_L; MPN GRM033R61A104ME15D; DIGIKEY 490-5405-1-ND
C36, C37, C38, C39: 4.7uF; RESC0603_L; MPN ZRB18AR6YA475KE05L; DIGIKEY 490-10992-1-ND
C43, C44, C45: 10uF; RESC0603_L; MPN GRM188R60J106KE47D; DIGIKEY 490-12538-1-ND
D1: GREEN; LED-0603
IC1: TPS6300; DRC-S-PVSON-N10
L3: 2.2uH; RESC0603_M; MPN LQM18PN2R2MGHD; DIGIKEY 490-14478-1-ND
R5: 100; R0603; MPN RC0603FR-07100RL; DIGIKEY 311-100HRCT-ND
R11: 1k; R0603; MPN RC0603JR-071KL; DIGIKEY 311-1.0KGRCT-ND
R13: 2k; R0603; MPN RC0603FR-072KL; DIGIKEY 311-2.00KHRCT-ND
R32: 200k; R0603; MPN RC0603JR-07200KL; DIGIKEY 311-200KGRTR-ND
R36: 1.3M; R0603; MPN RC0603FR-071M3L; DIGIKEY YAG3326CT-ND
R37: 2.2M; R0603; MPN RC0603JR-072M2L; DIGIKEY 311-2.2MGRCT-ND
R38: 10M; R0603; MPN RC0603JR-0710ML; DIGIKEY 311-10MGRCT-ND
U5: MAX8887EZK33+T; SOT-23-5
U6: MCP73831; DFN-8-MCP

Connections:
5V: C36.1, R11.2, U6.1 (VDD/1), U6.2 (VDD/2); also elsewhere on the board
!CHRG: D1.A, R11.1
BAT: C37.1, C43.1, IC1.5 (VIN), R5.2, R38.2, U6.3 (VBAT/3), U6.4 (VBAT/4); also elsewhere on the board
BATIN: C23.2, R37.2, R38.1; also elsewhere on the board
GND: C19.2, C23.1, C28.2, C36.2, C37.2, C38.2, C39.2, C43.2, C44.2, C45.2, IC1.3 (PGND), IC1.9 (GND), R13.1, R32.1, R37.1, U5.2 (GND), U6.6 (VSS), U6.GND; also elsewhere on the board
unnamed: R13.2, U6.8 (PROG)
unnamed: D1.C, U6.5 (STAT)
unnamed: IC1.4 (L1), L3.1
unnamed: IC1.2 (L2), L3.2
unnamed: C28.1, IC1.6 (EN), IC1.7 (PS/SYNC), IC1.8 (VINA), R5.1
unnamed: IC1.10 (FB), R32.2, R36.1
unnamed: C19.1, U5.4 (BP)
VCC: C39.1, U5.5 (OUT); also elsewhere on the board
VCCA: C38.1, C44.1, C45.1, IC1.1 (VOUT), R36.2, U5.1 (IN), U5.3 (!SHDN); also elsewhere on the board

Notes on the sheet:
VCCA = 3.8V

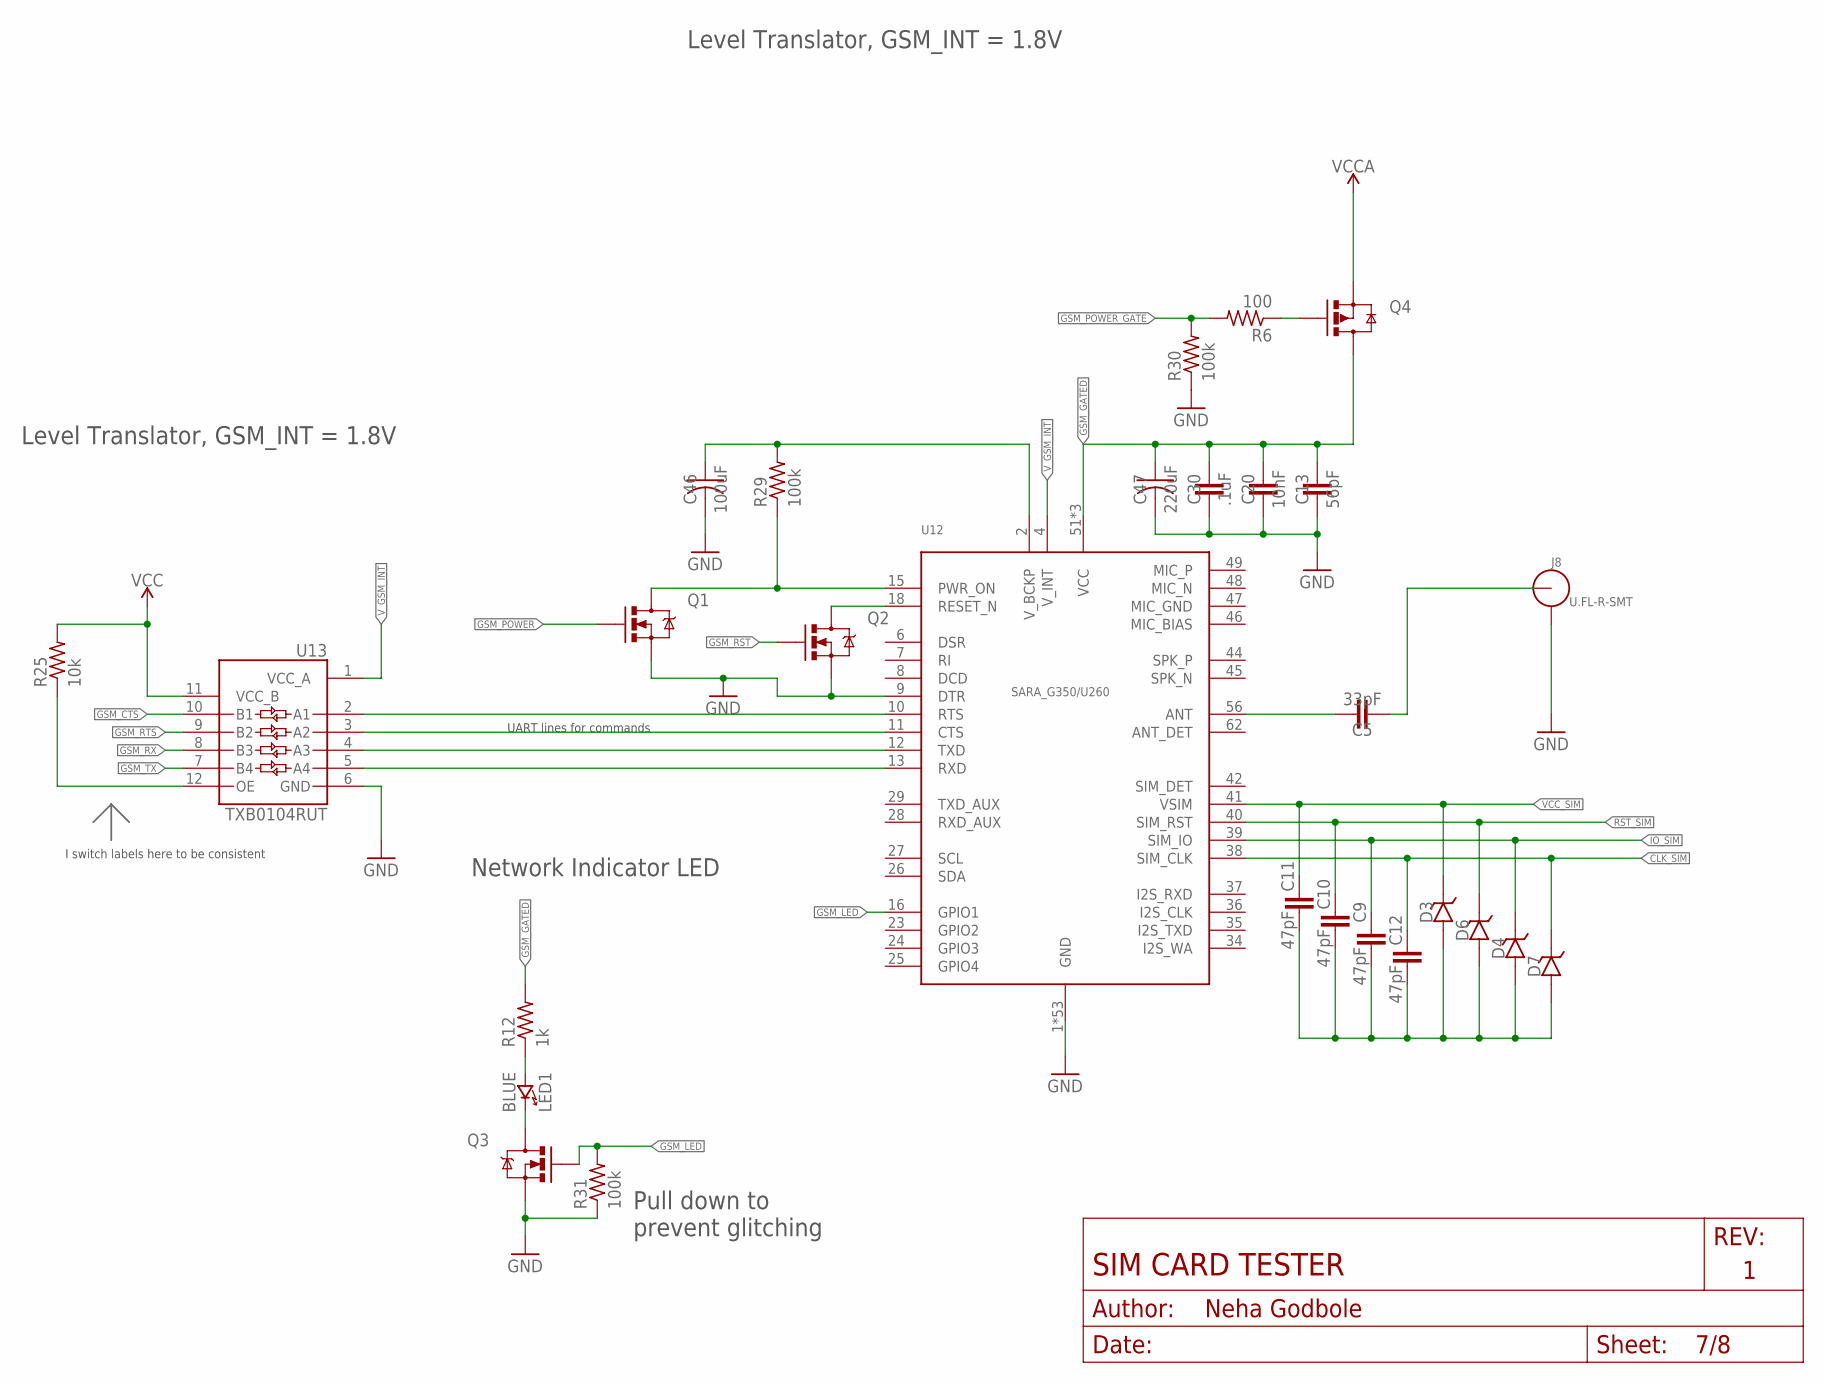
[picture p30: schematic schematic.sch, sheet 7, Sara U201]

Parts:
C5: 33pF; RESC0603_L; MPN C0603C330J1GACTU; DIGIKEY 399-7896-1-ND
C9, C10, C11, C12: 47pF; RESC0603_L; MPN CC0603JRNPO9BN470; DIGIKEY 311-1065-1-ND
C13: 56pF; RESC0603_L; MPN CC0603JRNPO9BN560; DIGIKEY 311-1066-1-ND
C20: 10nF; RESC0603_L; MPN GRM033R61E103KA12D; DIGIKEY 490-7194-1-ND
C30: .1uF; RESC0603_L; MPN GRM033R61A104ME15D; DIGIKEY 490-5405-1-ND
C46: 100uF; C1210; MPN GRM32ER61A107ME20L; DIGIKEY 490-9969-1-ND
C47: 220uF; C1210; MPN GRM32ER60J227ME05L; DIGIKEY 490-16308-1-ND
D3, D4, D6, D7: 14V; 0402_DIODE; MPN PESD0402-140; DIGIKEY PESD0402-140CT-ND
J8: U.FL-R-SMT; U.FL_SMT
LED1: BLUE; LED-0603; MPN SML-D12M8WT86; DIGIKEY 511-1578-1-ND
Q1, Q2, Q3: MOSFET-NCHANNELSMD; SOT23-3; MPN 2N7002LT1G; DIGIKEY 2N7002LT1GOSCT-ND
Q4: SI223DDS; SOT23-3
R6: 100; R0603; MPN RC0603FR-07100RL; DIGIKEY 311-100HRCT-ND
R12: 1k; R0603; MPN RC0603JR-071KL; DIGIKEY 311-1.0KGRCT-ND
R25: 10k; R0603; MPN RC0603JR-0710KL; DIGIKEY 311-10KGRCT-ND
R29, R30, R31: 100k; R0603; MPN RC0603JR-07100KL; DIGIKEY 311-100KGRCT-ND
U12: UBLOX_SARA_G350; UBLOX_SARA_G3
U13: TXB0104RUT; UQFN-12

Connections:
CLK_SIM: C12.1, D7.CATHODE, U12.38 (SIM_CLK); also elsewhere on the board
GND: C13.2, C20.2, C30.2, C46.2, C47.2, J8.GND1, J8.GND2, Q1.2 (S), Q2.2 (S), Q3.2 (S), R30.1, R31.1, U12.1 (GND), U12.3 (GND), U12.5 (GND), U12.9 (DTR), U12.14 (GND), U12.20 (GND), U12.21 (GND), U12.22 (GND), U12.30 (GND), U12.32 (GND), U12.33 (GND), U12.43 (GND), U12.50 (GND), U12.54 (GND), U12.55 (GND), U12.57 (GND), U12.58 (GND), U12.59 (GND), U12.60 (GND), U12.61 (GND), U12.63 (GND), U12.64 (GND), U12.65 (GND), U12.66 (GND), U12.67 (GND), U12.68 (GND), U12.69 (GND), U12.70 (GND), U12.71 (GND), U12.72 (GND), U12.73 (GND), U12.74 (GND), U12.75 (GND), U12.76 (GND), U12.77 (GND), U12.78 (GND), U12.79 (GND), U12.80 (GND), U12.81 (GND), U12.82 (GND), U12.83 (GND), U12.84 (GND), U12.85 (GND), U12.86 (GND), U12.87 (GND), U12.88 (GND), U12.89 (GND), U12.90 (GND), U12.91 (GND), U12.92 (GND), U12.93 (GND), U12.94 (GND), U12.95 (GND), U12.96 (GND), U13.6 (GND); also elsewhere on the board
GSM_CTS: U13.10 (B1); also elsewhere on the board
GSM_GATED: C13.1, C20.1, C30.1, C47.1, Q4.3 (D), R12.2, U12.51 (VCC), U12.52 (VCC), U12.53 (VCC)
GSM_LED: Q3.1 (G), R31.2, U12.16 (GPIO1)
GSM_POWER: Q1.1 (G); also elsewhere on the board
GSM_POWER_GATE: R6.2, R30.2
GSM_RST: Q2.1 (G); also elsewhere on the board
GSM_RTS: U13.9 (B2); also elsewhere on the board
GSM_RX: U13.8 (B3); also elsewhere on the board
GSM_TX: U13.7 (B4); also elsewhere on the board
IO_SIM: C9.1, D4.CATHODE, U12.39 (SIM_IO); also elsewhere on the board
unnamed: U12.12 (TXD), U13.4 (A3)
unnamed: U12.13 (RXD), U13.5 (A4)
unnamed: LED1.C (CATHODE), Q3.3 (D)
unnamed: Q2.3 (D), U12.18 (RESET_N)
unnamed: C46.1, R29.2, U12.2 (V_BCKP)
unnamed: Q1.3 (D), R29.1, U12.15 (PWR_ON)
unnamed: LED1.A (ANODE), R12.1
unnamed: U12.11 (CTS), U13.3 (A2)
unnamed: U12.10 (RTS), U13.2 (A1)
unnamed: Q4.1 (G), R6.1
unnamed: R25.1, U13.12 (OE)
unnamed: C5.1, U12.56 (ANT)
unnamed: C5.2, J8.SIG (ANT)
unnamed: C9.2, C10.2, C11.2, C12.2, D3.ANODE, D4.ANODE, D6.ANODE, D7.ANODE
RST_SIM: C10.1, D6.CATHODE, U12.40 (SIM_RST); also elsewhere on the board
VCC: R25.2, U13.11 (VCC_B); also elsewhere on the board
VCCA: Q4.2 (S); also elsewhere on the board
VCC_SIM: C11.1, D3.CATHODE, U12.41 (VSIM); also elsewhere on the board
V_GSM_INT: U12.4 (V_INT), U13.1 (VCC_A)

Notes on the sheet:
Level Translator, GSM_INT = 1.8V
I switch labels here to be consistent
UART lines for commands
Network Indicator LED
Pull down to prevent glitching
