lab11/persimmon/hardware/sim_card_tester/schematic.brd

## EAGLE design hardware/sim_card_tester/schematic.brd (continued)

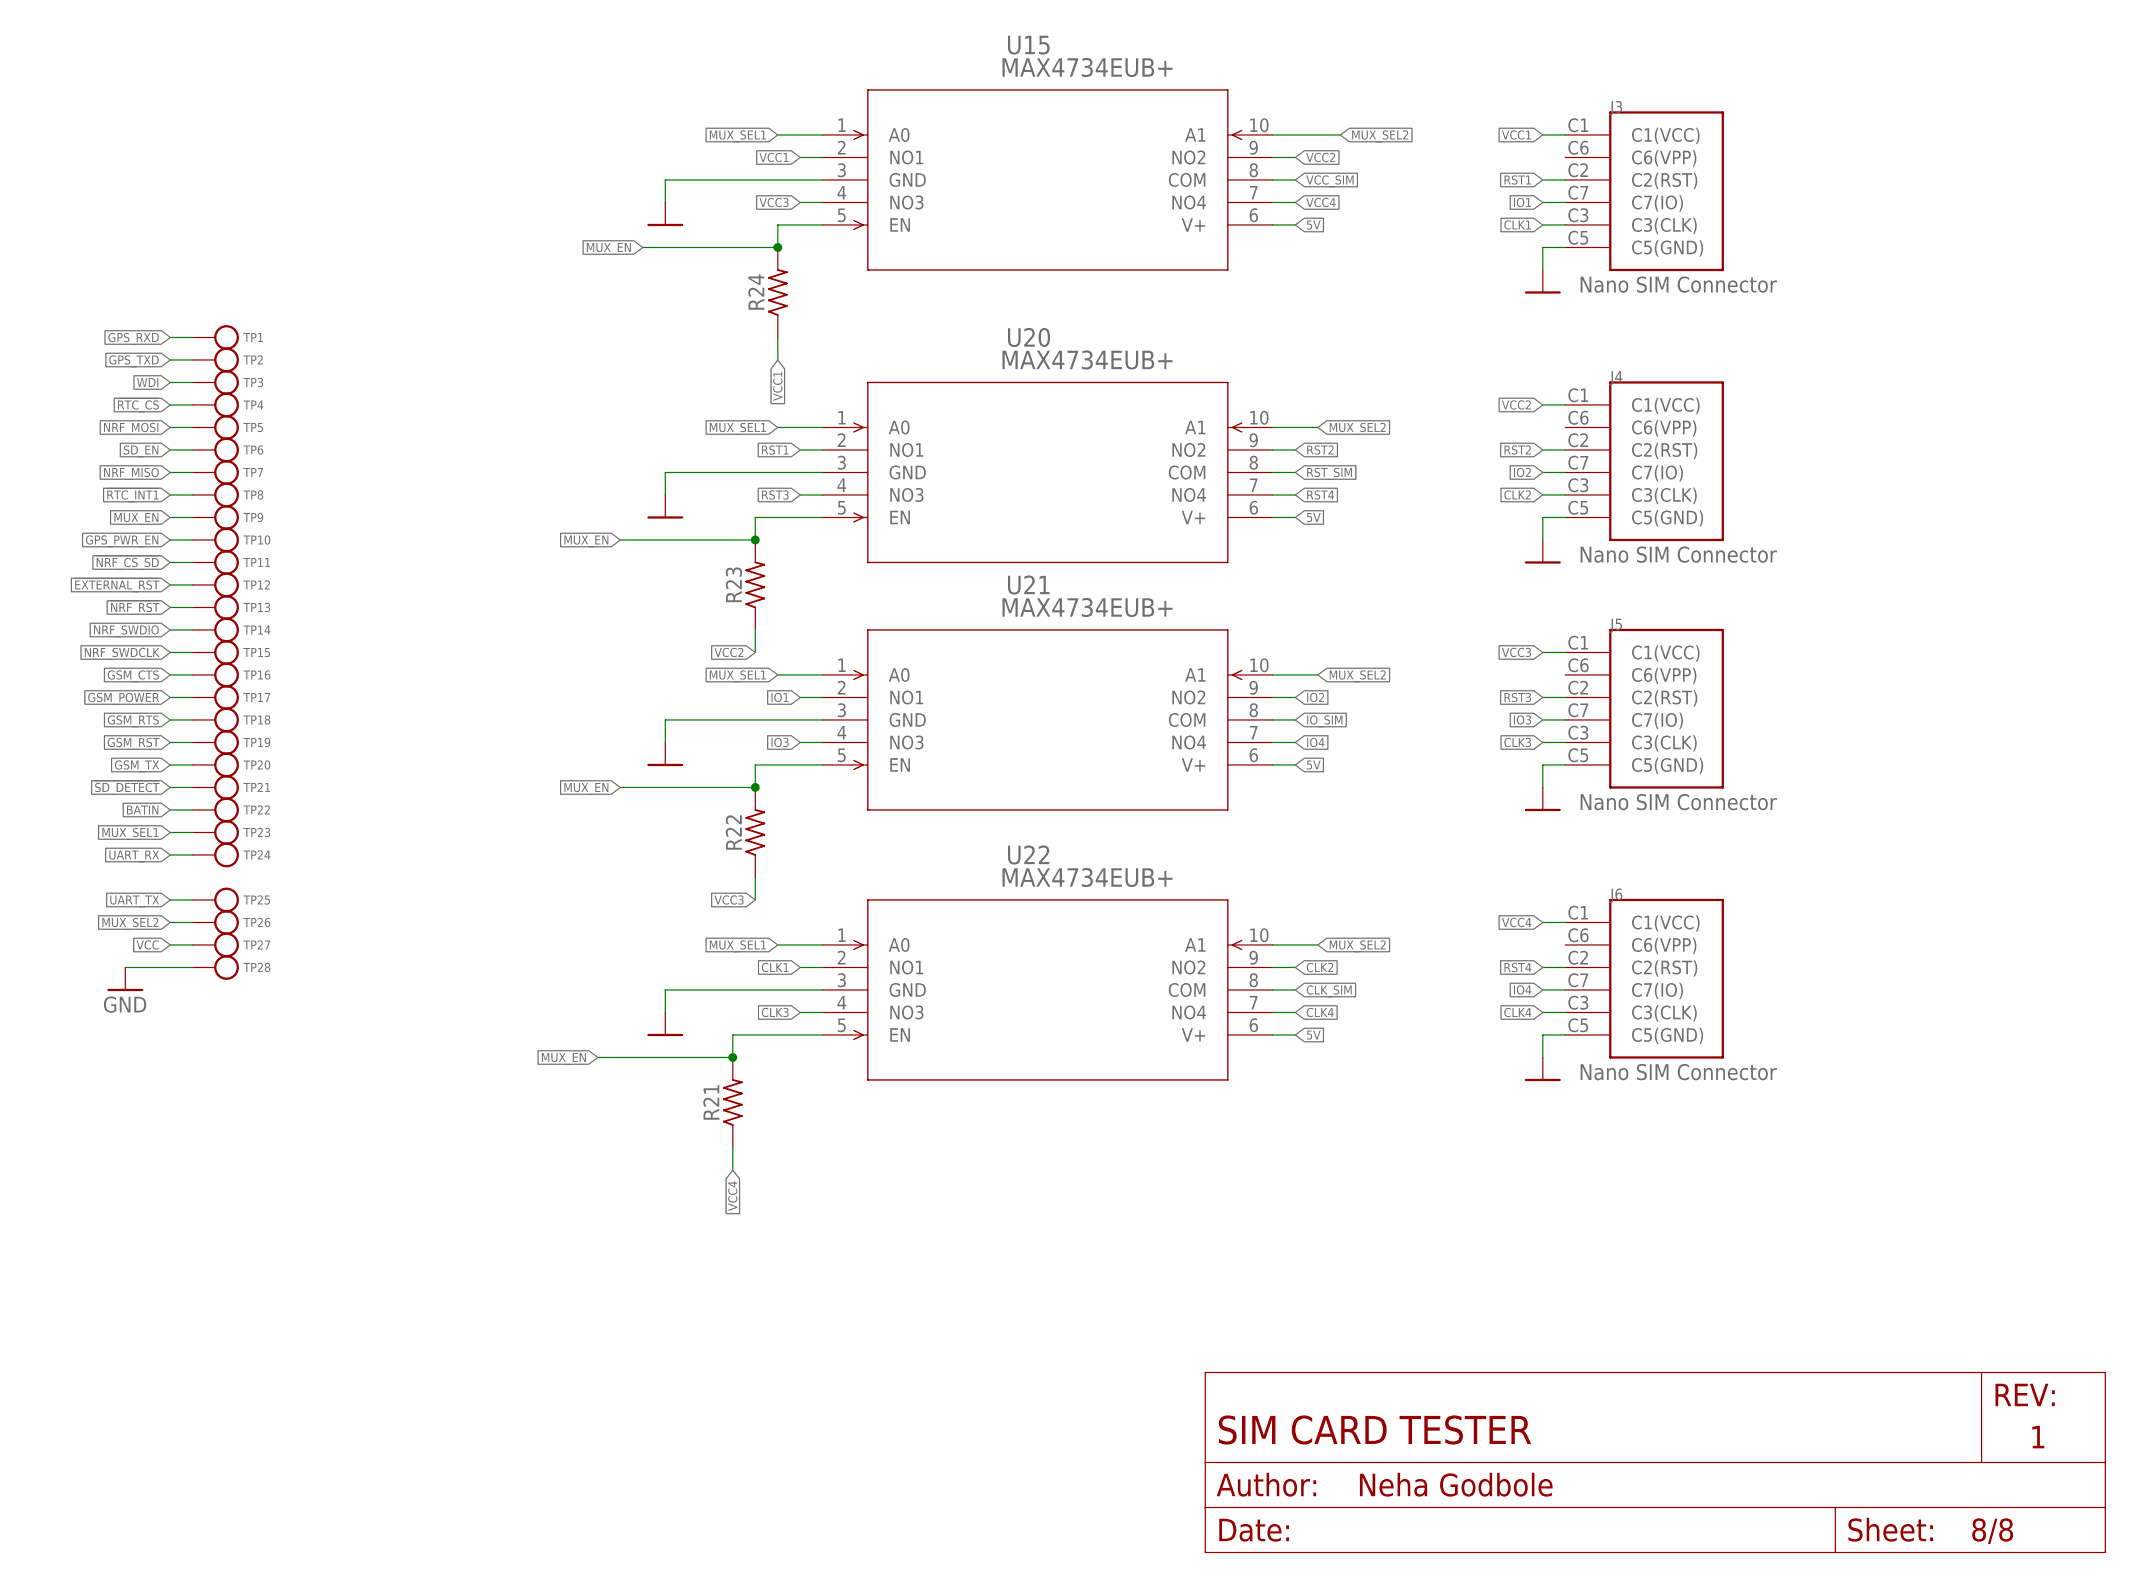
[picture p31: schematic schematic.sch, sheet 8, Sim Card Muxes]

Parts:
J3, J4, J5, J6: NANO_SIM; WURTH_NANO_SIM
R21, R22, R23, R24: 10k; R0603; MPN RC0603JR-0710KL; DIGIKEY 311-10KGRCT-ND
TP1, TP2, TP3, TP4, TP5, TP6, TP7, TP8, TP9, TP10, TP11, TP12, TP13, TP14, TP15, TP16, TP17, TP18, TP19, TP20, TP21, TP22, TP23, TP24, TP25, TP26, TP27, TP28: TEST-POINT; PAD.03X.03
U15, U20, U21, U22: MAX4734EUB+; 21-0061L

Connections:
5V: U15.6 (V+), U20.6 (V+), U21.6 (V+), U22.6 (V+); also elsewhere on the board
!EXTERNAL_RST: TP12.P$1; also elsewhere on the board
!NRF_CS_SD: TP11.P$1; also elsewhere on the board
!NRF_RST: TP13.P$1; also elsewhere on the board
!RTC_CS: TP4.P$1; also elsewhere on the board
!RTC_INT1: TP8.P$1; also elsewhere on the board
!SD_DETECT: TP21.P$1; also elsewhere on the board
BATIN: TP22.P$1; also elsewhere on the board
CLK1: J3.C3 (C3(CLK)), U22.2 (NO1)
CLK2: J4.C3 (C3(CLK)), U22.9 (NO2)
CLK3: J5.C3 (C3(CLK)), U22.4 (NO3)
CLK4: J6.C3 (C3(CLK)), U22.7 (NO4)
CLK_SIM: U22.8 (COM); also elsewhere on the board
GND: J3.C5 (C5(GND)), J4.C5 (C5(GND)), J5.C5 (C5(GND)), J6.C5 (C5(GND)), TP28.P$1, U15.3 (GND), U20.3 (GND), U21.3 (GND), U22.3 (GND); also elsewhere on the board
GPS_PWR_EN: TP10.P$1; also elsewhere on the board
GPS_RXD: TP1.P$1; also elsewhere on the board
GPS_TXD: TP2.P$1; also elsewhere on the board
GSM_CTS: TP16.P$1; also elsewhere on the board
GSM_POWER: TP17.P$1; also elsewhere on the board
GSM_RST: TP19.P$1; also elsewhere on the board
GSM_RTS: TP18.P$1; also elsewhere on the board
GSM_TX: TP20.P$1; also elsewhere on the board
IO1: J3.C7 (C7(IO)), U21.2 (NO1)
IO2: J4.C7 (C7(IO)), U21.9 (NO2)
IO3: J5.C7 (C7(IO)), U21.4 (NO3)
IO4: J6.C7 (C7(IO)), U21.7 (NO4)
IO_SIM: U21.8 (COM); also elsewhere on the board
MUX_EN: R21.2, R22.2, R23.2, R24.2, TP9.P$1, U15.5 (EN), U20.5 (EN), U21.5 (EN), U22.5 (EN); also elsewhere on the board
MUX_SEL1: TP23.P$1, U15.1 (A0), U20.1 (A0), U21.1 (A0), U22.1 (A0); also elsewhere on the board
MUX_SEL2: TP26.P$1, U15.10 (A1), U20.10 (A1), U21.10 (A1), U22.10 (A1); also elsewhere on the board
NRF_MISO: TP7.P$1; also elsewhere on the board
NRF_MOSI: TP5.P$1; also elsewhere on the board
NRF_SWDCLK: TP15.P$1; also elsewhere on the board
NRF_SWDIO: TP14.P$1; also elsewhere on the board
RST1: J3.C2 (C2(RST)), U20.2 (NO1)
RST2: J4.C2 (C2(RST)), U20.9 (NO2)
RST3: J5.C2 (C2(RST)), U20.4 (NO3)
RST4: J6.C2 (C2(RST)), U20.7 (NO4)
RST_SIM: U20.8 (COM); also elsewhere on the board
SD_EN: TP6.P$1; also elsewhere on the board
UART_RX: TP24.P$1; also elsewhere on the board
UART_TX: TP25.P$1; also elsewhere on the board
VCC: TP27.P$1; also elsewhere on the board
VCC1: J3.C1 (C1(VCC)), R24.1, U15.2 (NO1)
VCC2: J4.C1 (C1(VCC)), R23.1, U15.9 (NO2)
VCC3: J5.C1 (C1(VCC)), R22.1, U15.4 (NO3)
VCC4: J6.C1 (C1(VCC)), R21.1, U15.7 (NO4)
VCC_SIM: U15.8 (COM); also elsewhere on the board
WDI: TP3.P$1; also elsewhere on the board

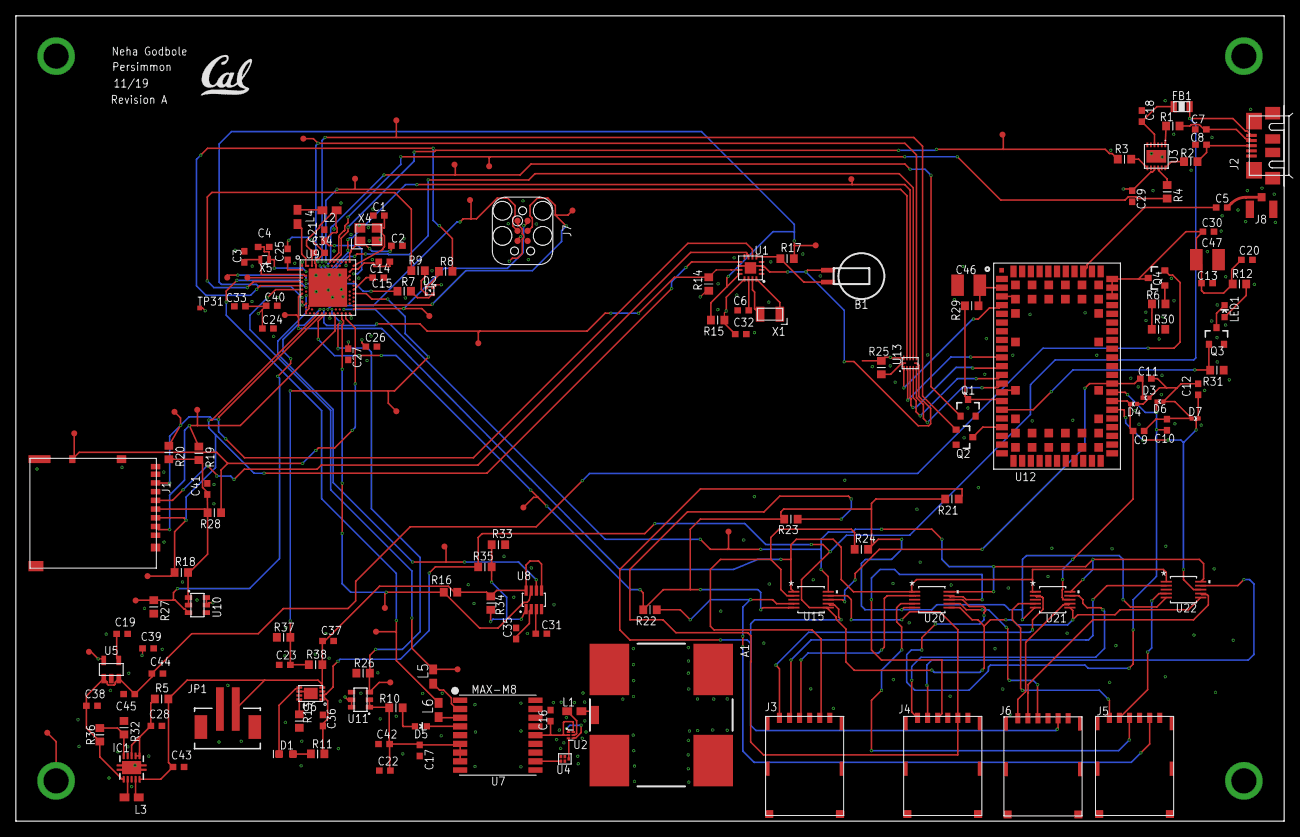
[picture p32: board schematic.brd from above]

Board: 4 copper layers, 160.0 x 101.6 mm, 168 parts (0 on the bottom side), 122 nets.

Other parts of the board:
U$3: UCB_CAL_200MIL
