lab11/persimmon/(commit log)

2019-09-04 first pcb
    [schematic.brd, schematic.sch]
2019-09-14 second pcb
    [schematic.brd, schematic.sch]
2019-10-02 fixed schematic and nrf routing
    [schematic.brd, schematic.sch]
2019-10-09 fixed most things
    [schematic.brd]
2019-10-22 fixed via and pad problem
    [schematic.brd]
2019-10-22 commit before renumber
    [schematic.brd, schematic.csv]
2019-10-29 fixed drc errors
    [schematic.brd, schematic.sch]
2019-11-02 add ground vias, label parts, clean up board
    [schematic.brd, schematic.sch]
2019-11-02 fixed some wires
    [schematic.brd]
2019-11-03 updated parts for caps
    [schematic.brd, schematic.sch]
2019-11-03 parts for resistors
    [schematic.brd, schematic.sch]
2019-11-03 added most of the parts
    [schematic.brd, schematic.sch]
2019-11-03 renumbering again
    [schematic.brd, schematic.csv, schematic.sch]
2019-11-03 fixed numbering
    [schematic.brd, schematic.csv, schematic.sch]
2019-11-12 cleaned up wires
    [schematic.brd, schematic.sch]
2019-11-17 added test points
    [schematic.brd, schematic.sch]
2019-11-18 updated bom
    [bom.csv, schematic.brd, schematic.sch]
2019-11-19 adding zip files
    [persimmon_bom.csv, persimmon_bom.xlsx]
